skrubis/vectrix-vehicleman/kicad/2025-03-03 01_26_59-ESP32-WROVER-E-PINOUT-DIAGRAM-scaled.jpg (WEBP Image, 1600 × 1153 pixels) – Scal.png

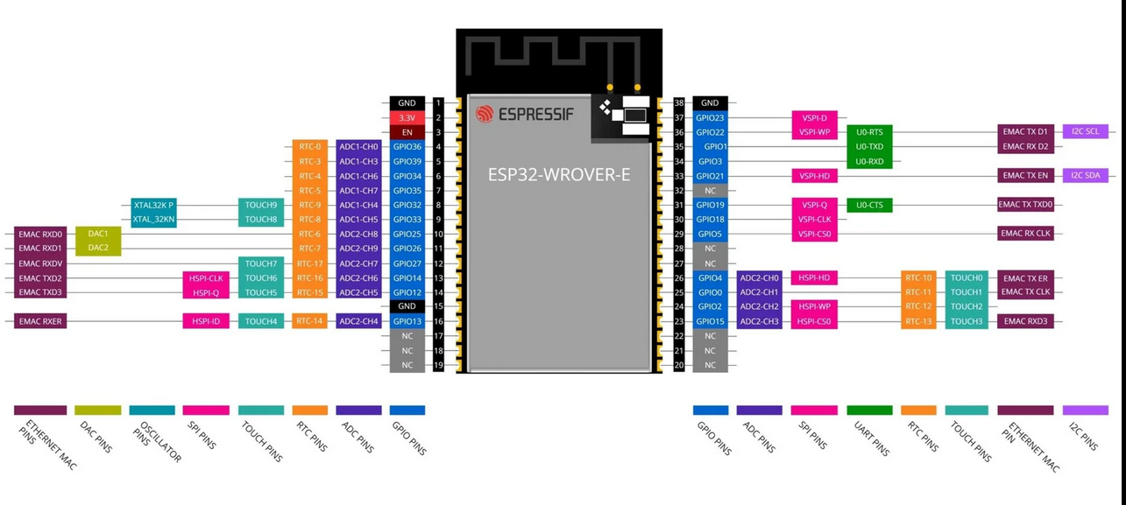
kicad/2025-03-03 01_26_59-ESP32-WROVER-E-PINOUT-DIAGRAM-scaled.jpg (WEBP Image, 1600 × 1153 pixels) – Scal.png
