skrubis/vectrix-vehicleman/other-hw/battery-tap-fuse-adapter/battery-fuse-adapter/production/bom.csv

Designator | Footprint | Quantity | Value | LCSC Part #
F1, F10, F11, F12, F13, F14, F15, F16, F17, F2, F3, F4, F5, F6, F7, F8, F9 | 0603 | 17 | 100mA PF | C369142
J2 | C430372 | 1 | Screw_Terminal_01x17 | C430372
