skrubis/vectrix-vehicleman/kicad/TL494x.step

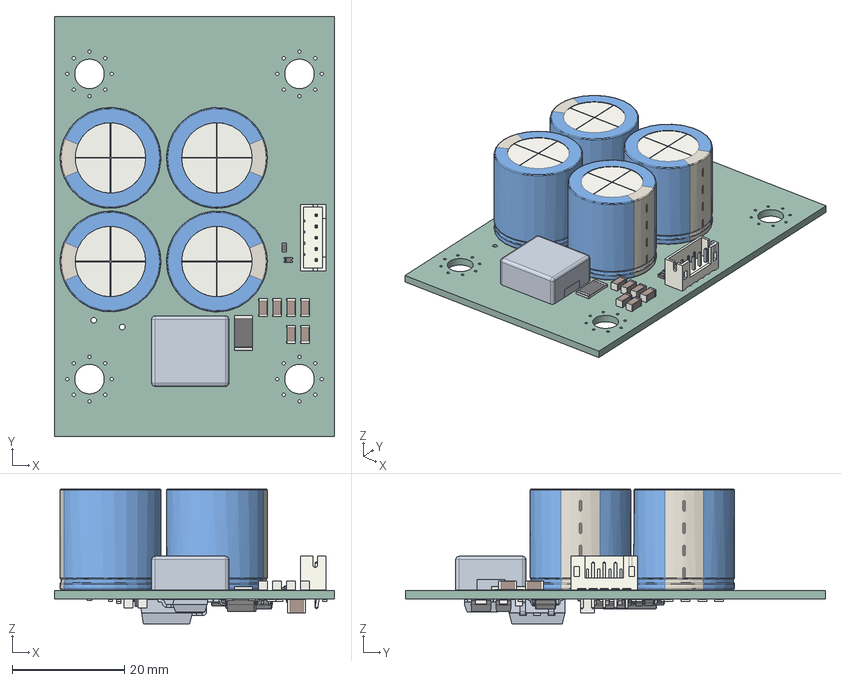
[picture p2: CAD file, 2025-03-02]
kicad/TL494x.step
50.0 x 75.0 x 24.1 mm
CP_Radial_D18.0mm_P7.50mm x 4
JST_PH_B5B-PH-K_1x05_P2.00mm_Vertical
TL494x 1.4.1
C_1206_3216Metric x 8
R_0603_1608Metric x 26
D_0603_1608Metric
R_2512_6332Metric
SOT-23 x 2
SOIC-8_3.9x4.9mm_P1.27mm
D_SOD-323 x 2
SOT-363_SC-70-6
C_0603_1608Metric x 7
C_1210_3225Metric
D_SMA
SOT-223
D_SMB
TL494x 1.52.1
C_0805_2012Metric
SOIC-16_3.9x9.9mm_P1.27mm
TL494x 1.57.1
TL494V2OC_PCB
