skrubis/vectrix-vehicleman/kicad/vectrix-vehicleman-0.pdf

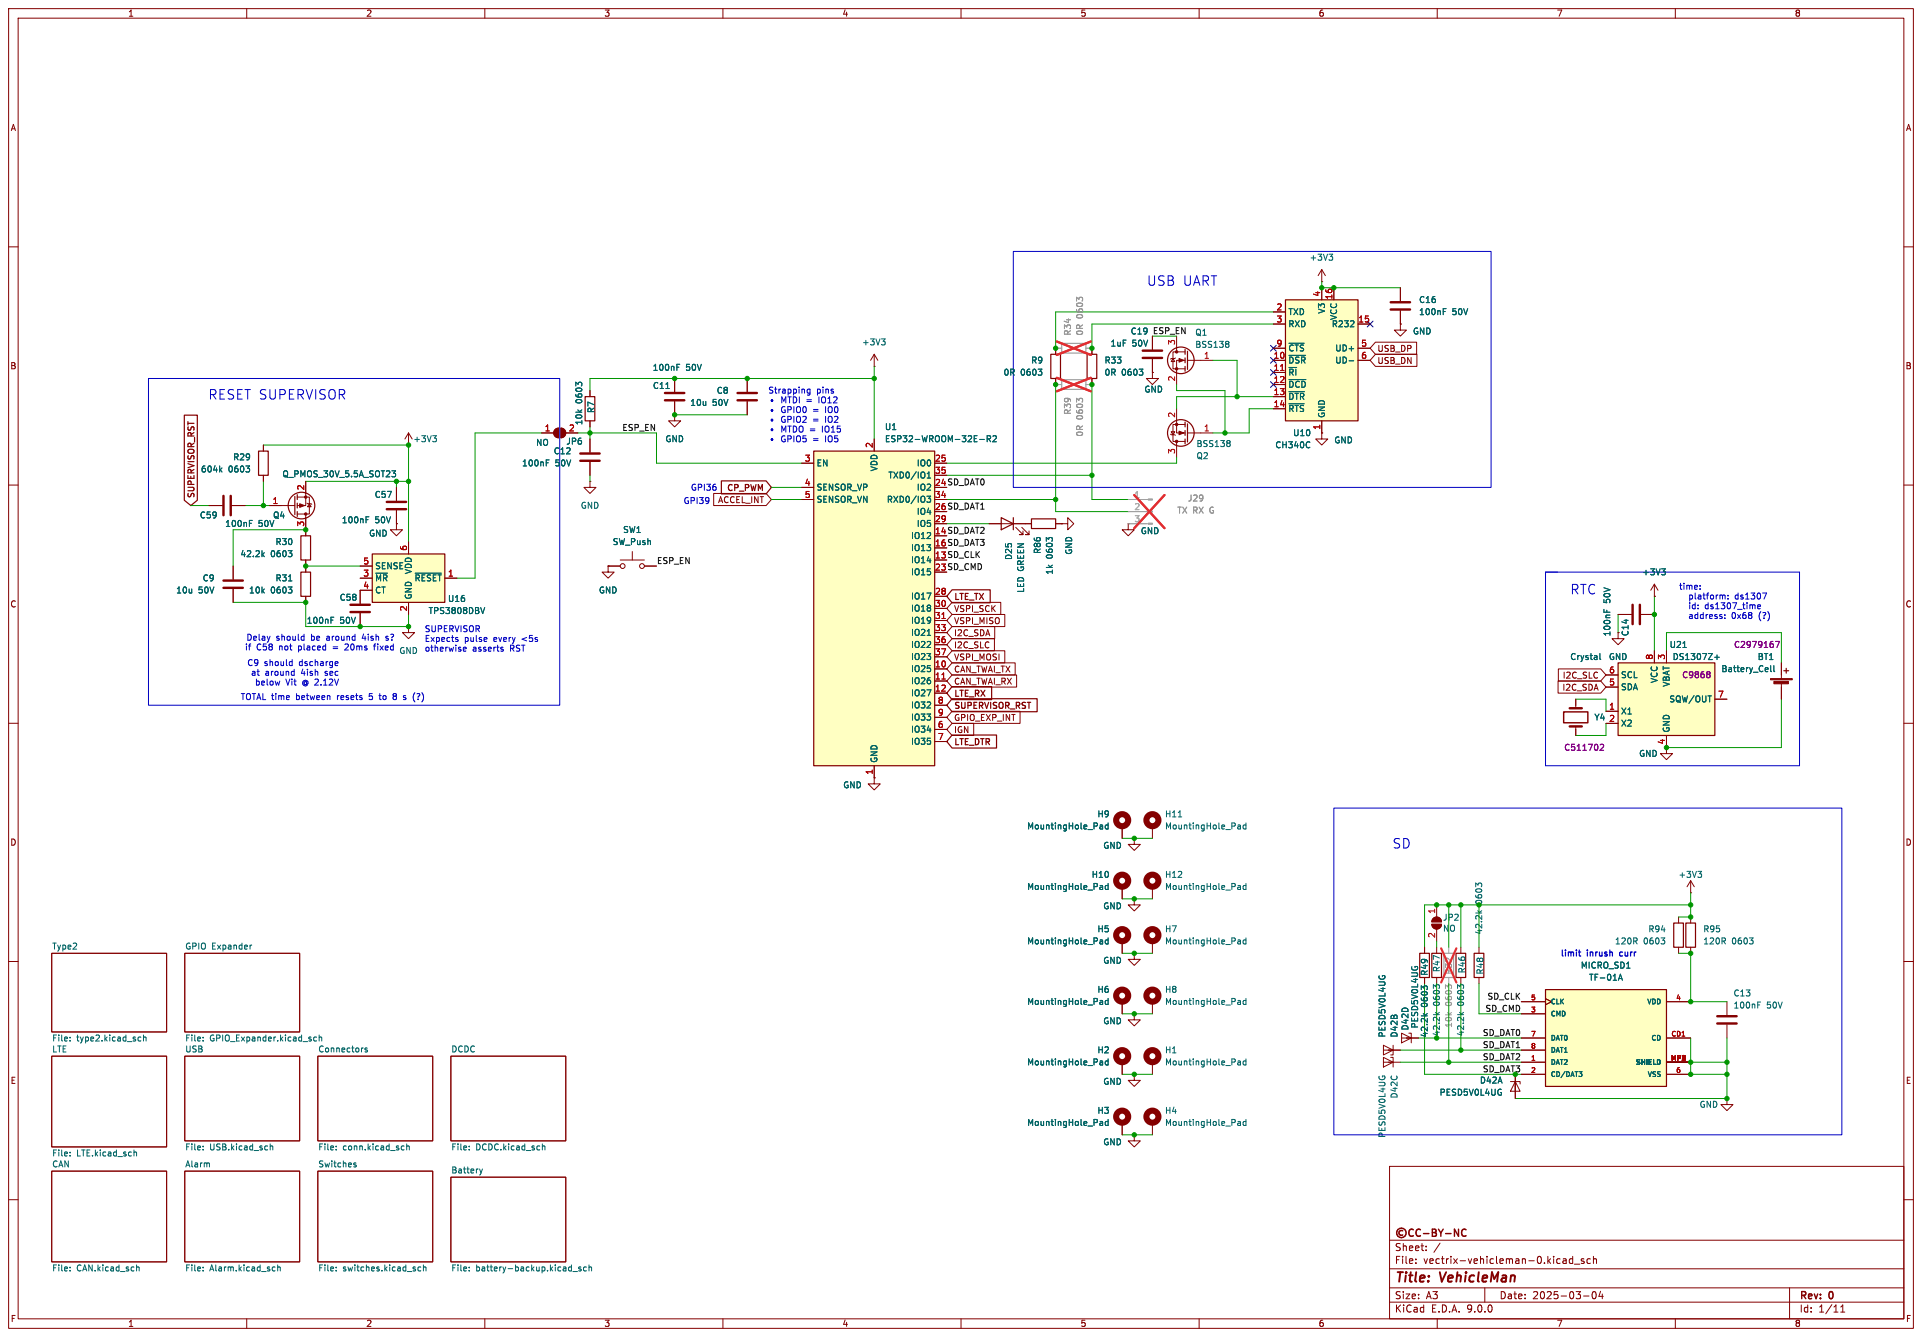
[picture p3: page 1]

1 TXD 2 RXD 3 ~{CTS} 9 ~{DSR} 10 ~{RI} 11 ~{DCD} 12 ~{DTR} 13 ~{RTS} 14 GND GND R34 0R 0603

1 TXD 2 RXD 3 ~{CTS} 9 ~{DSR} 10 ~{RI} 11 ~{DCD} 12 ~{DTR} 13 ~{RTS} 14 U10 CH340C GND

Delay should be around 4ish s?

TOTAL time between resets 5 to 8 s (?)

File: vectrix-vehicleman-0.kicad_sch Sheet: / þÿ©CC-BY-NC

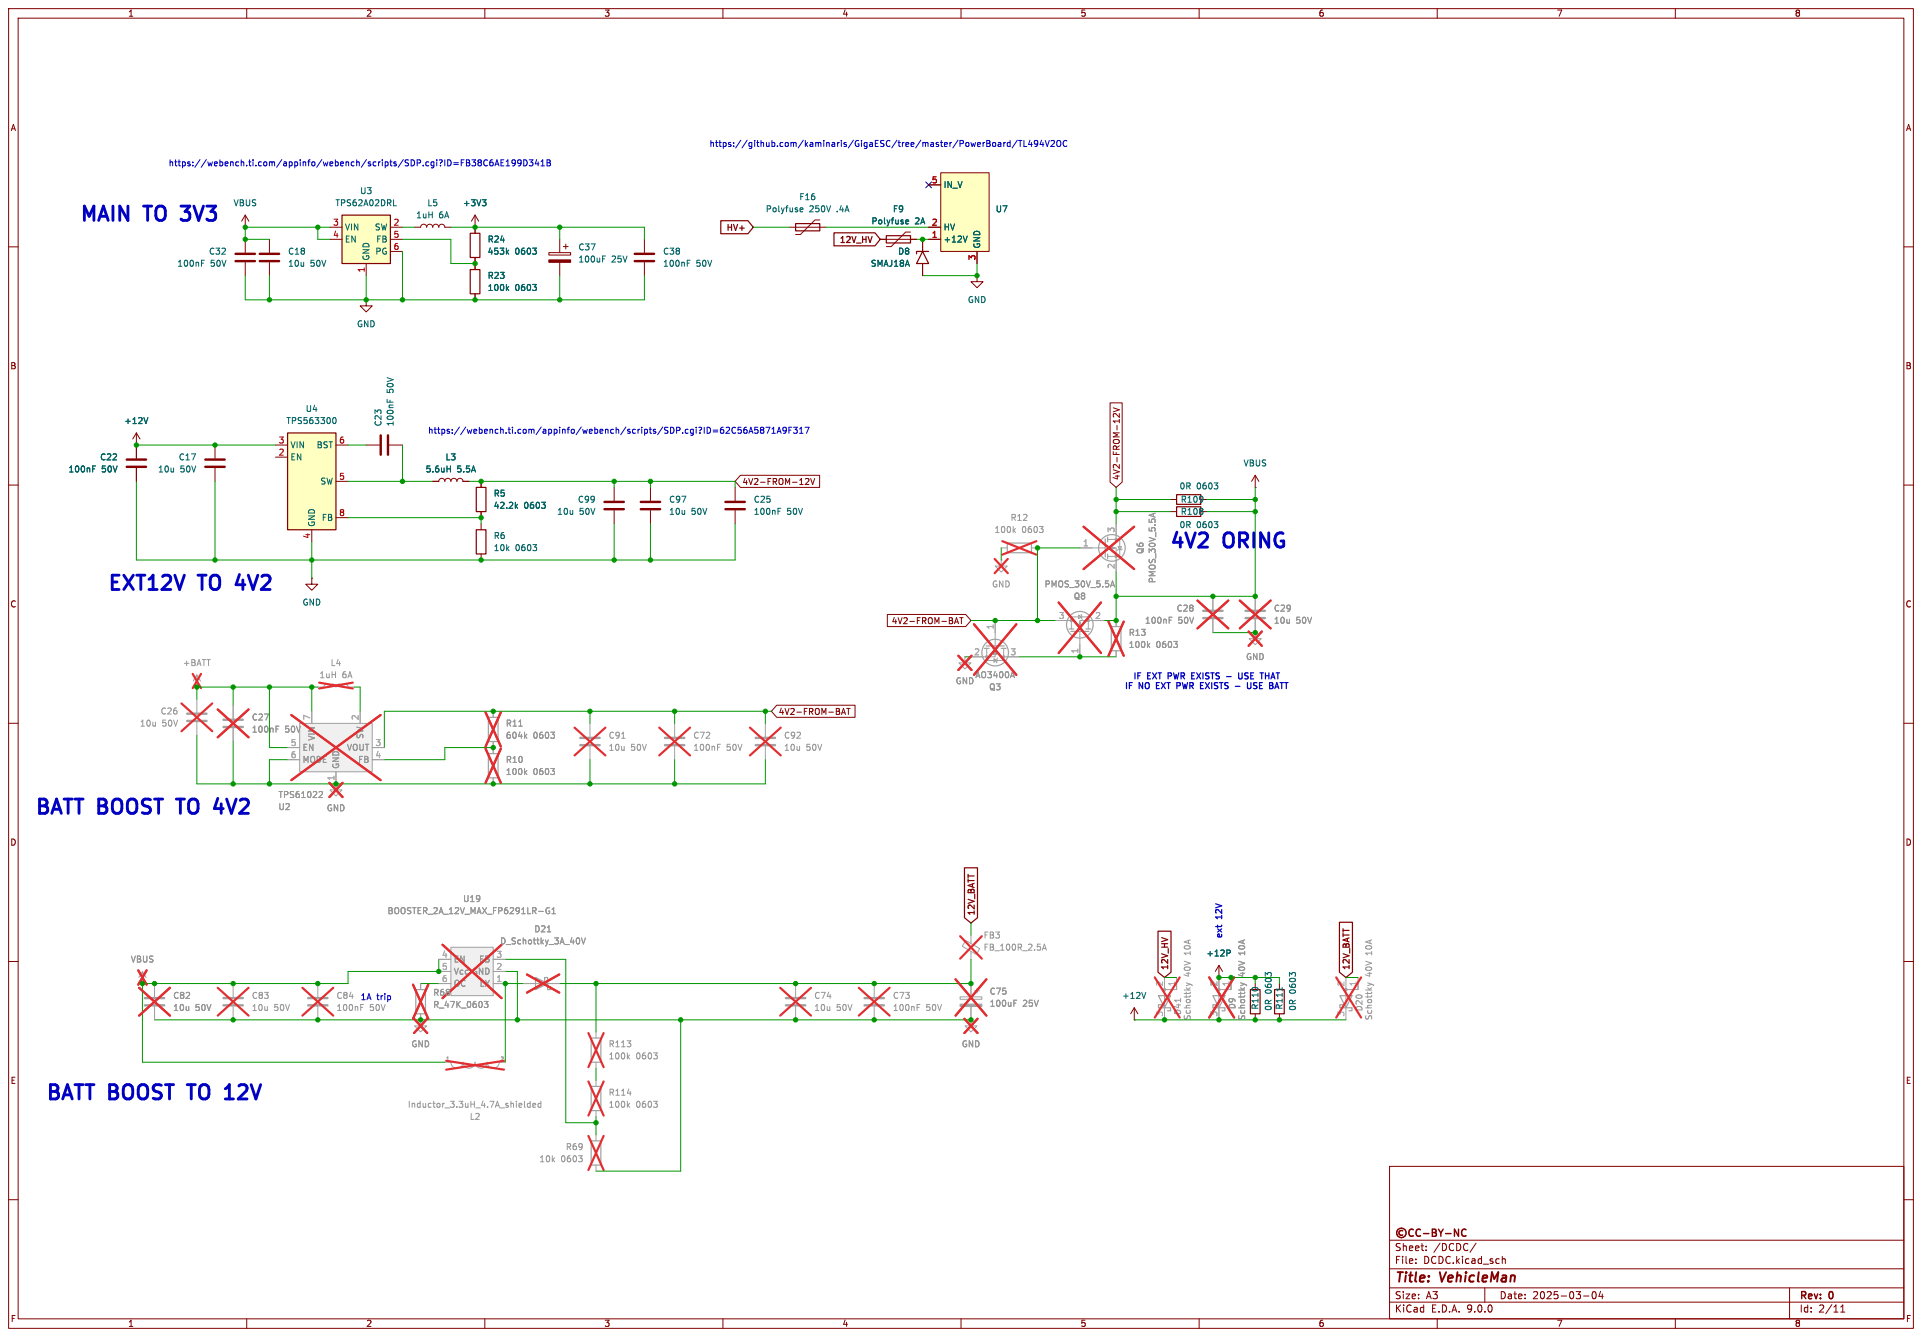
[picture p4: page 2]

https://github.com/kaminaris/GigaESC/tree/master/PowerBoard/TL494V2OC

https://webench.ti.com/appinfo/webench/scripts/SDP.cgi?ID=62C56A5871A9F317

IF NO EXT PWR EXISTS - USE BATT EXT12V TO 4V2

IF EXT PWR EXISTS - USE THAT

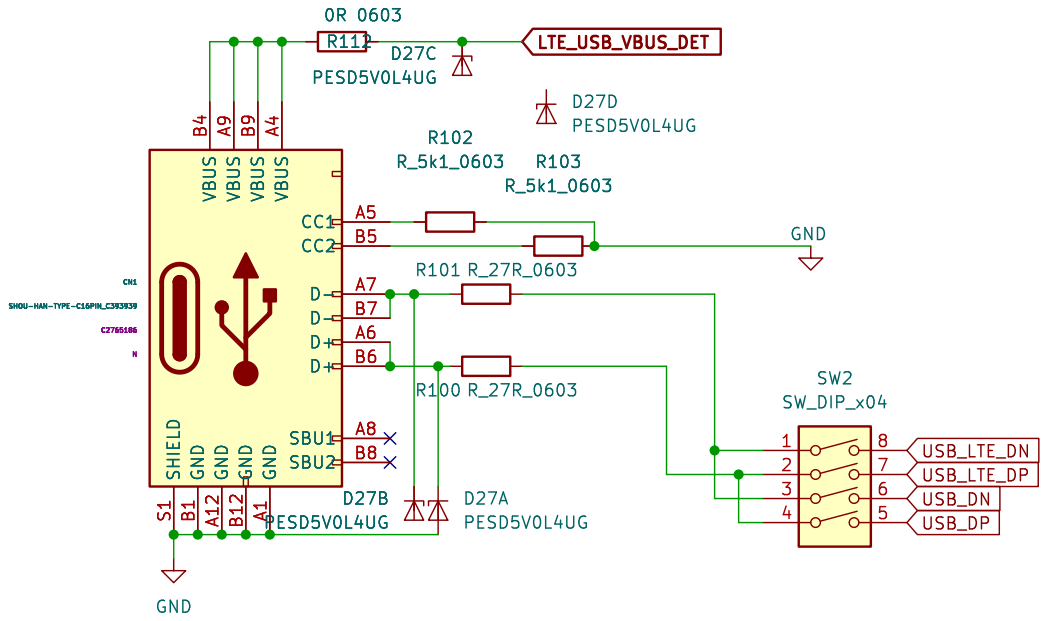
[picture p5: page 3]

File: USB.kicad_sch Sheet: /USB/ þÿ©CC-BY-NC

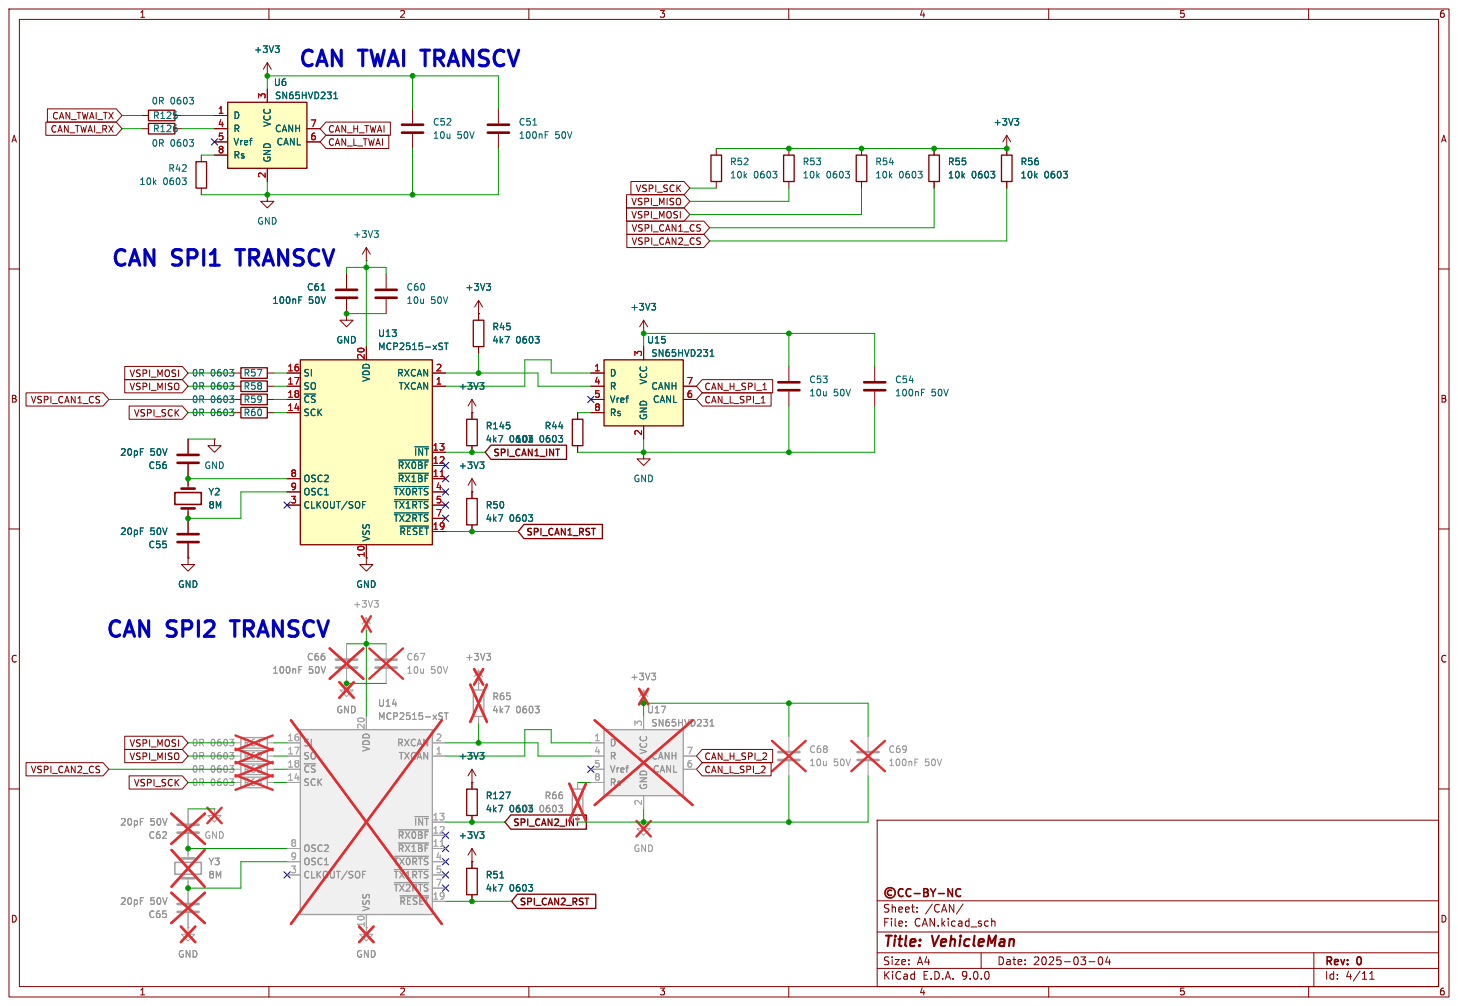
[picture p6: page 4]

File: CAN.kicad_sch Sheet: /CAN/ þÿ©CC-BY-NC

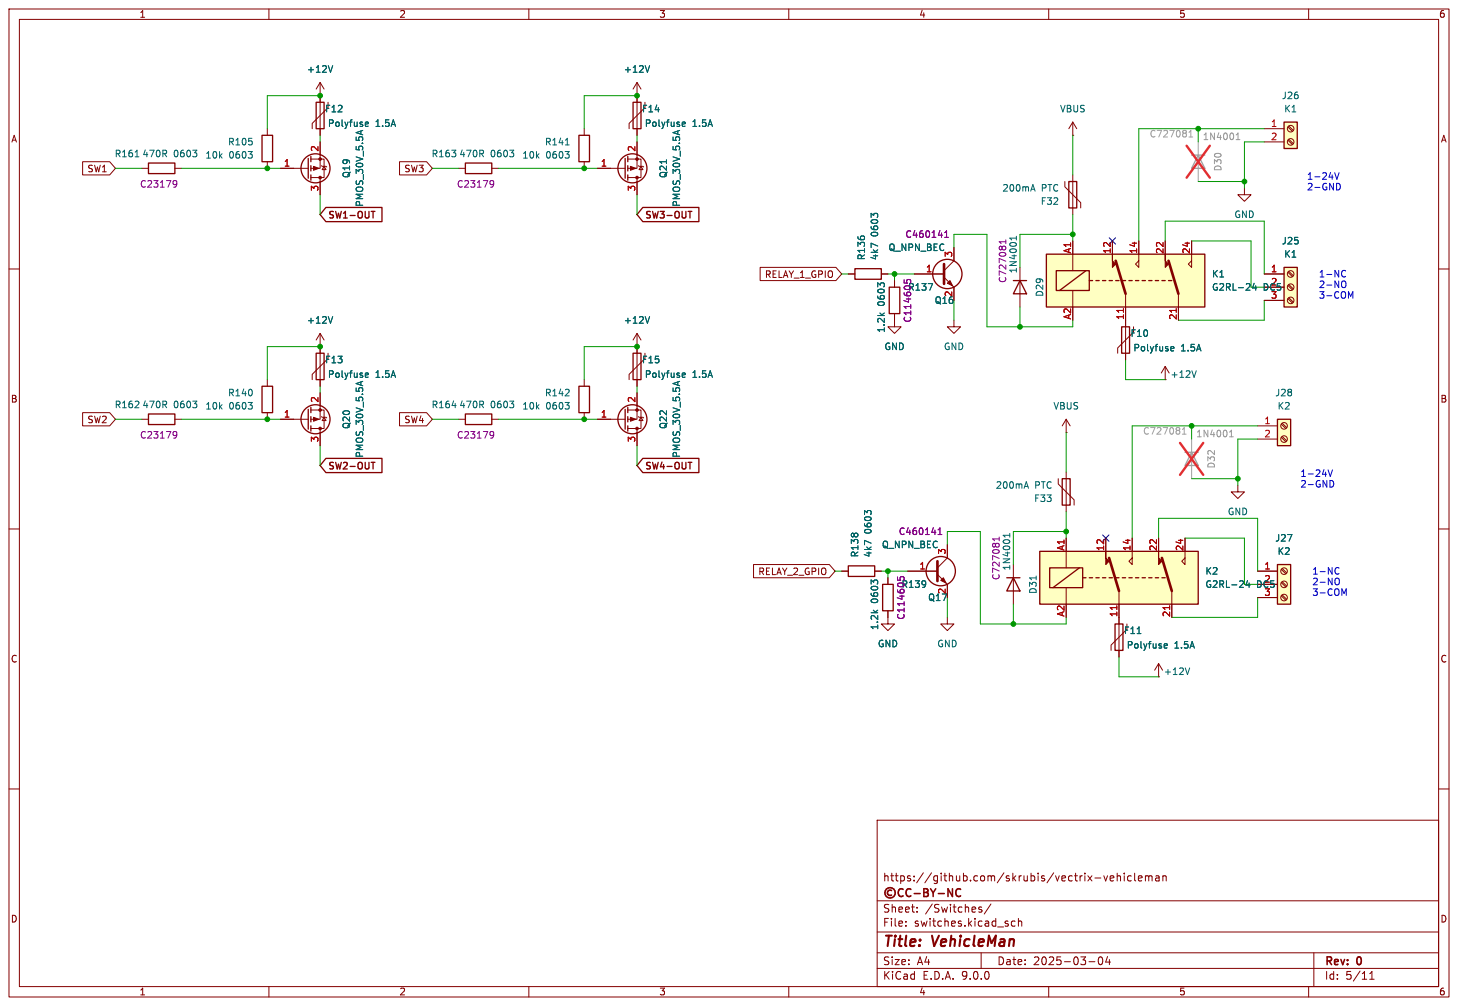
[picture p7: page 5]

https://github.com/skrubis/vectrix-vehicleman D31 1N4001 C727081 1

File: switches.kicad_sch Sheet: /Switches/ þÿ©CC-BY-NC

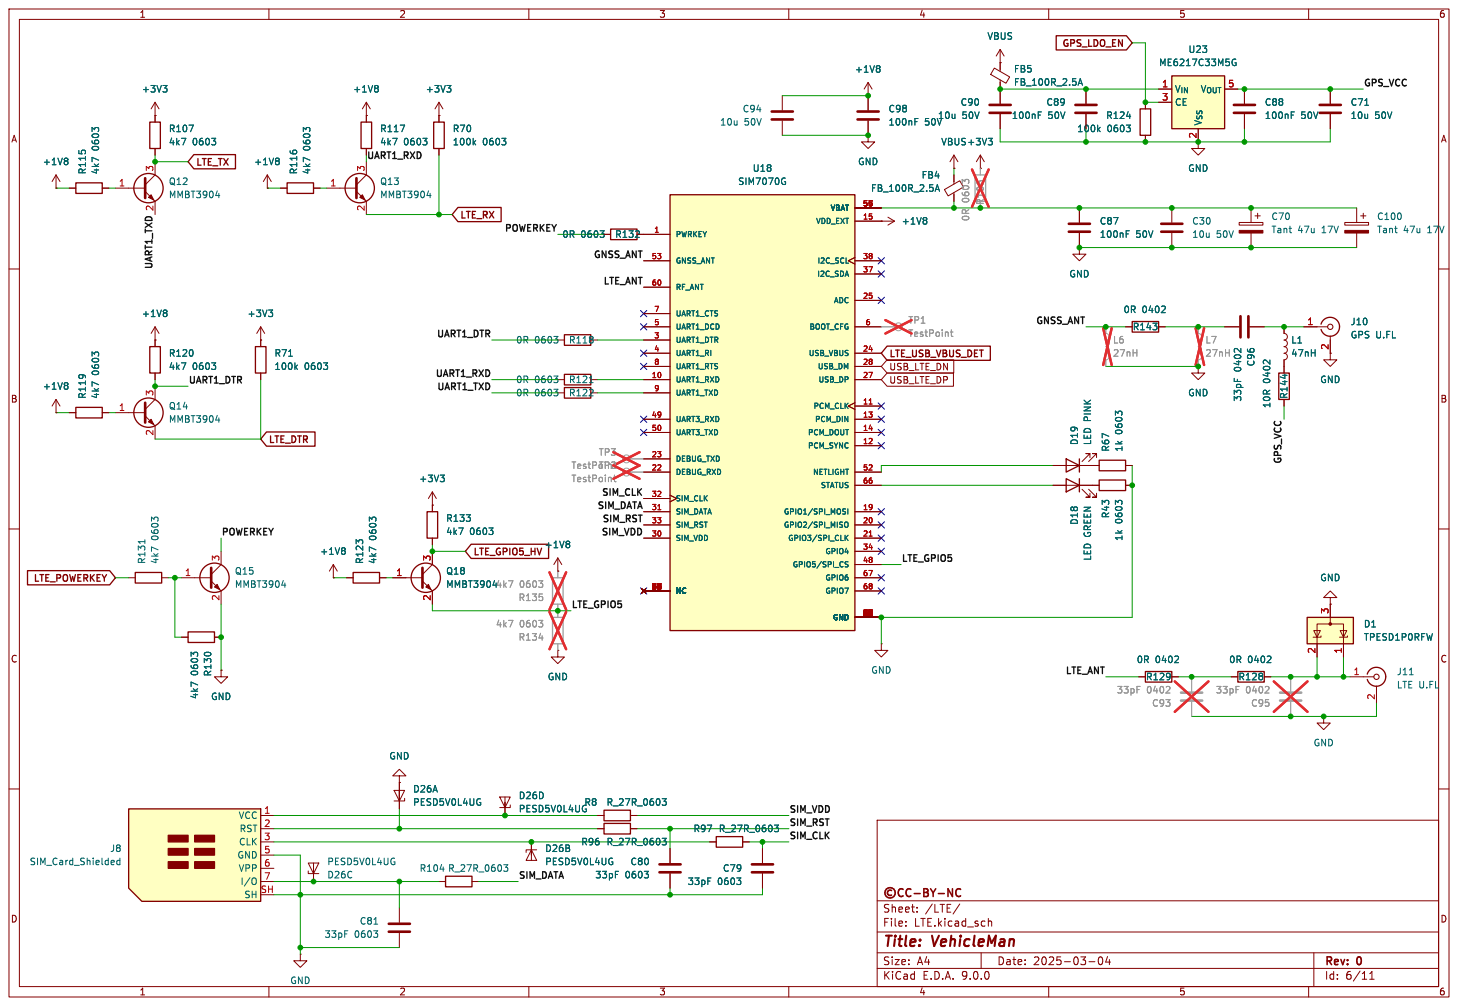
[picture p8: page 6]

+1V8 VCC 1 RST 2 CLK 3 GND 5 VPP 6

File: LTE.kicad_sch Sheet: /LTE/ þÿ©CC-BY-NC

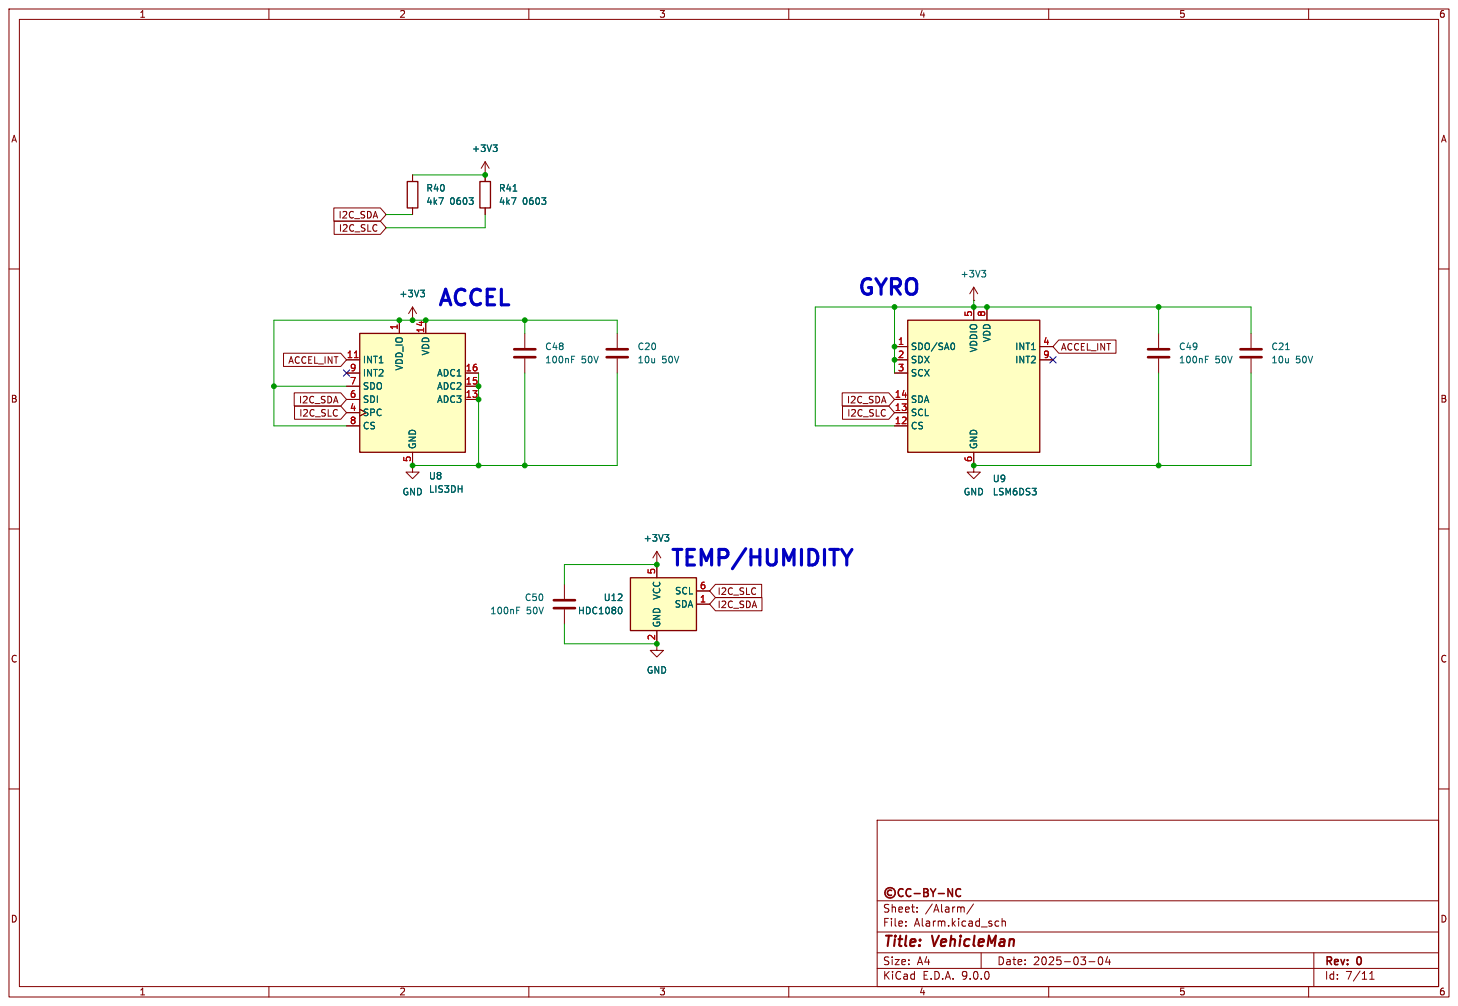
[picture p9: page 7]

File: Alarm.kicad_sch Sheet: /Alarm/ þÿ©CC-BY-NC

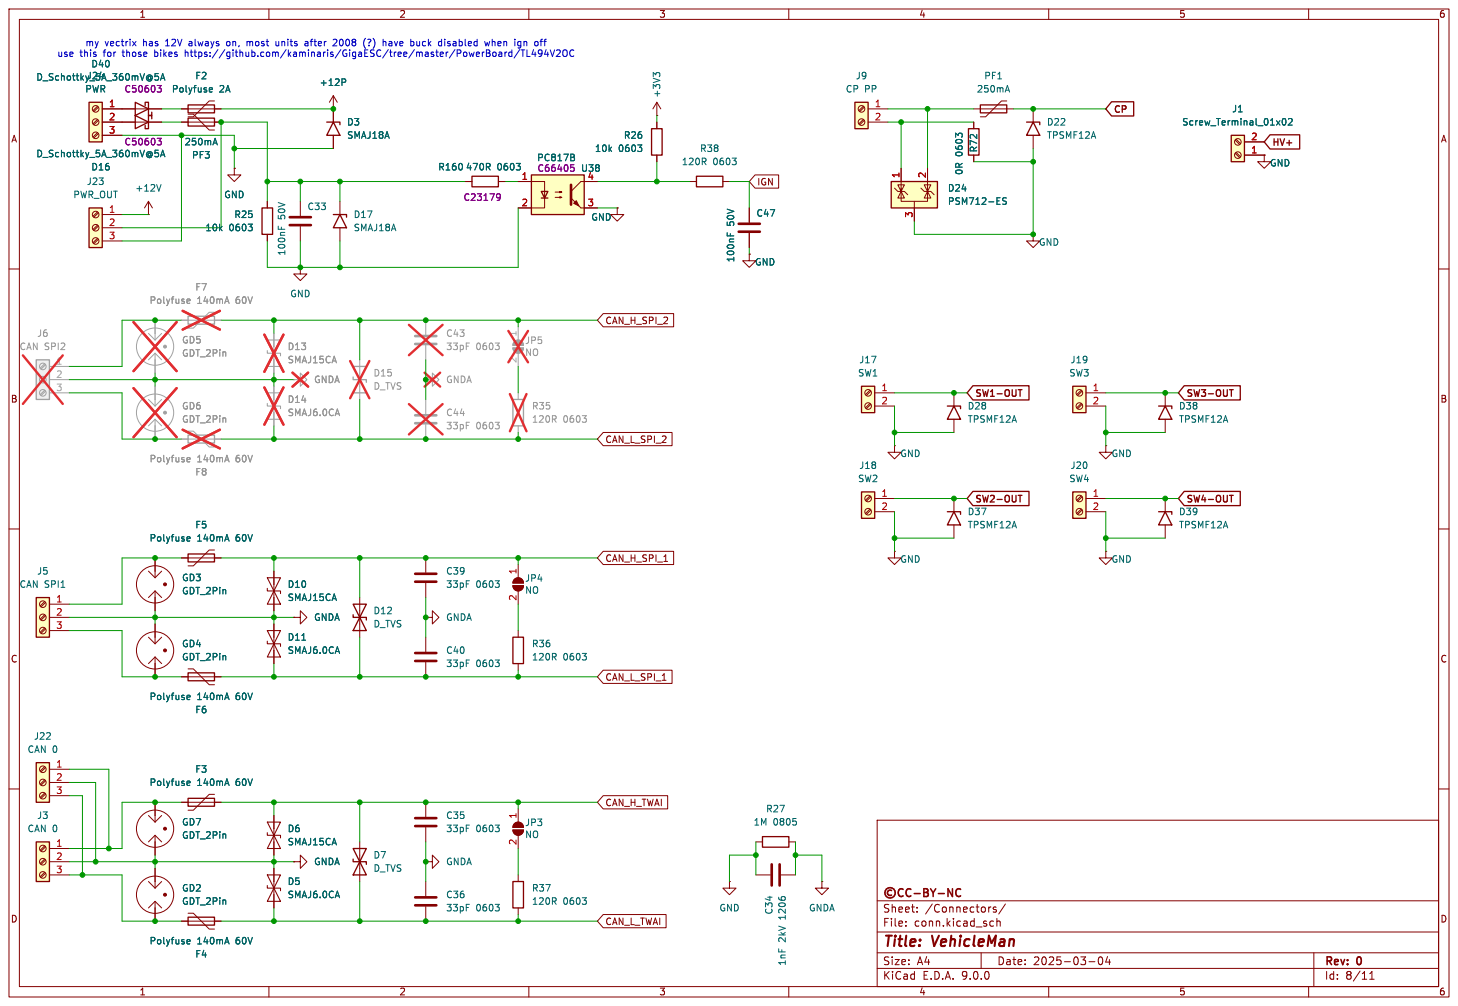
[picture p10: page 8]

File: conn.kicad_sch Sheet: /Connectors/ þÿ©CC-BY-NC

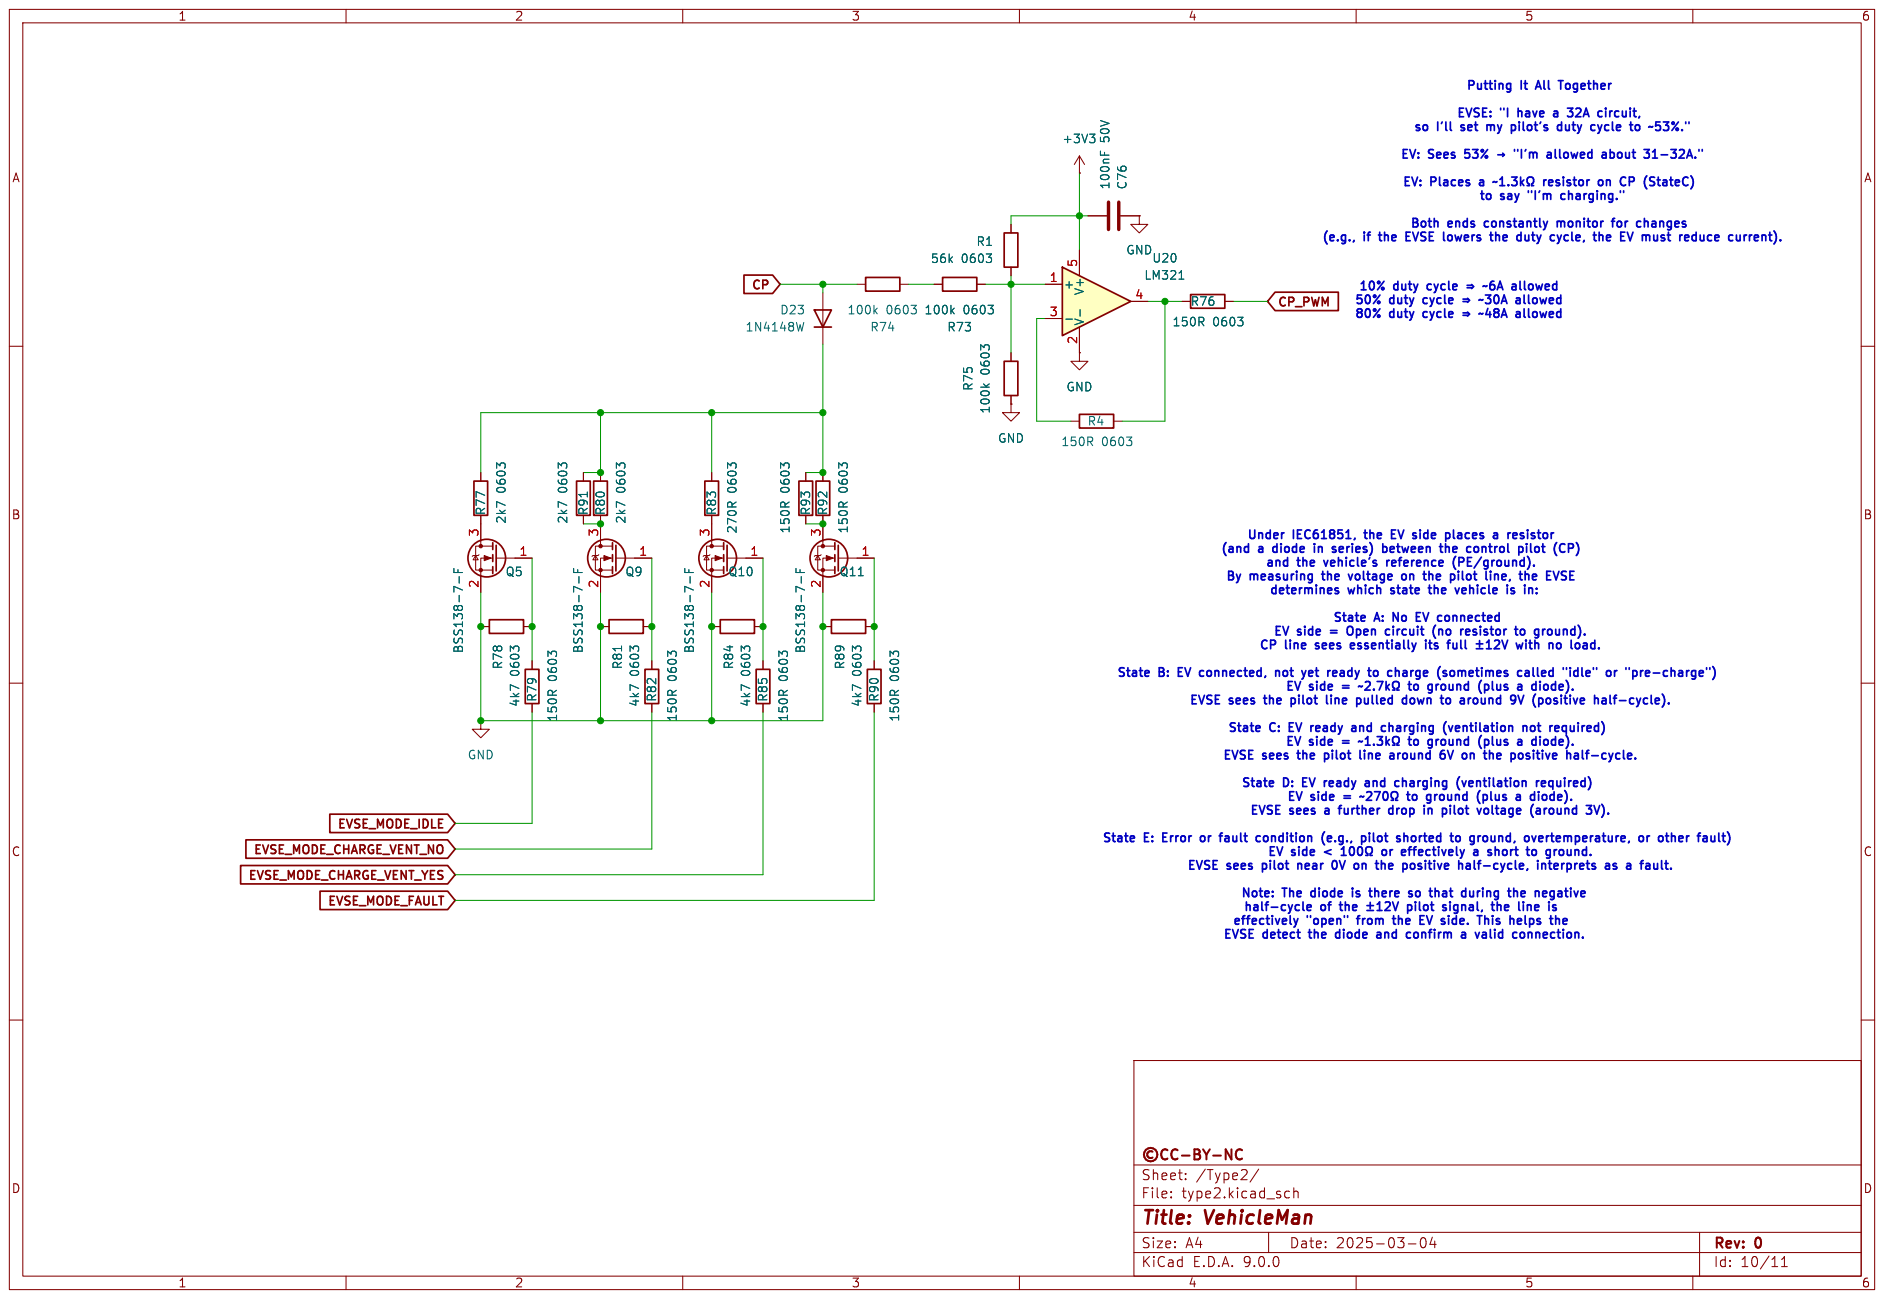
[picture p11: page 9]

80% duty cycle þÿ!Òþÿ~48 /A allowed Putting It All Together EVSE: "I have a þÿ32 /Acircuit, so I'll set my pilot's duty cycle to ~53%." EV: Sees 53% þÿ!’"I'm allowed about þÿ31-32 /A." EV: Places a þÿ~1.3 /k© resistor on CP þÿ(State /C)

to say "I'm charging." Both ends constantly monitor for changes

(e.g., if the EVSE lowers the duty cycle, the EV must reduce current). R75 100k 0603 R1

10% duty cycle þÿ!Òþÿ~6 /A allowed
50% duty cycle þÿ!Òþÿ~30 /A allowed

Under þÿIEC /61851, the EV side places a resistor
(and a diode in series) between the control pilot (CP) and the vehicle's reference (PE/ground).

By measuring the voltage on the pilot line, the EVSE

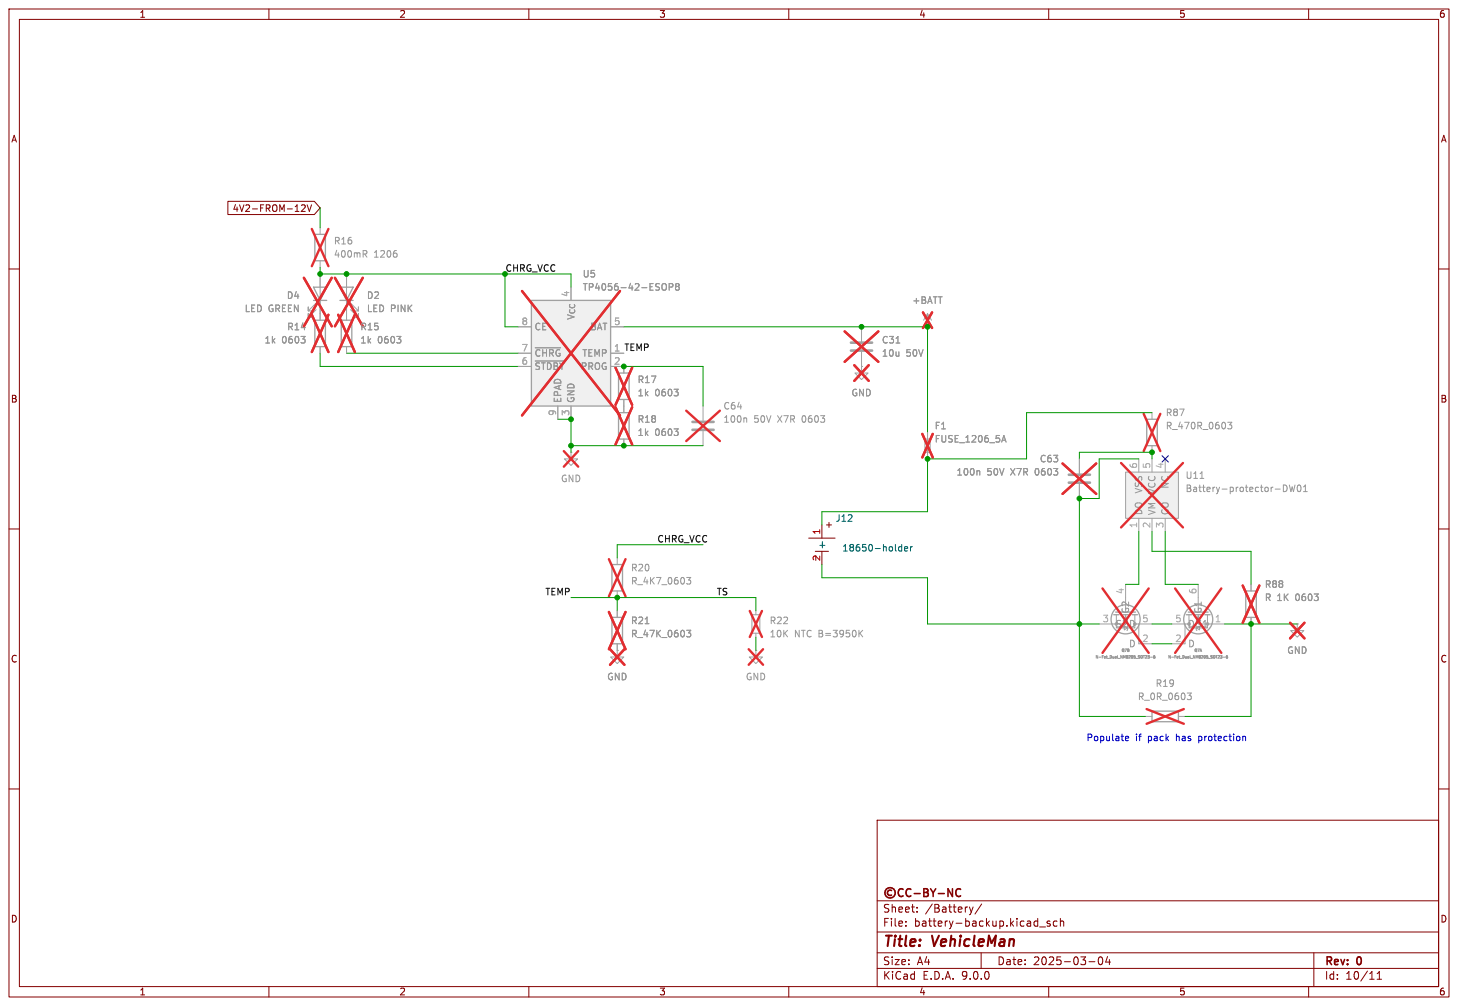
[picture p12: page 10]

File: battery-backup.kicad_sch Sheet: /Battery/
Id: 10/11 Title: VehicleMan

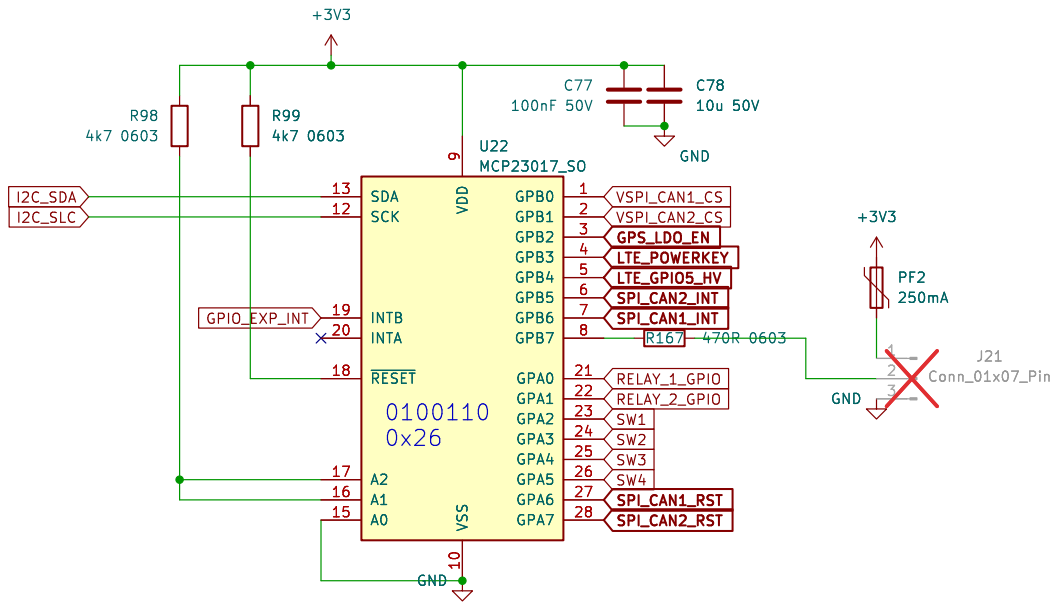
[picture p13: page 11]
