skrubis/vectrix-vehicleman/other-hw/battery-tap-fuse-adapter/battery-fuse-adapter/battery-fuse-adapter.kicad_pcb

## KiCad design other-hw/battery-tap-fuse-adapter/battery-fuse-adapter/battery-fuse-adapter.kicad_pcb (2025-03-06)

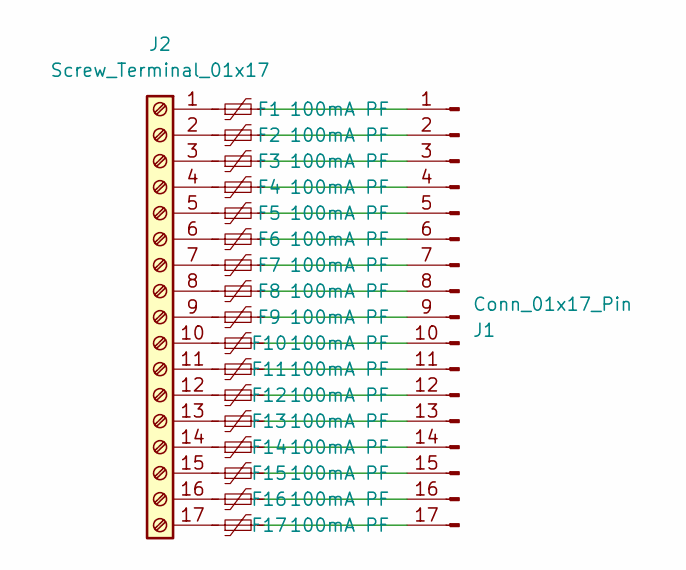
[picture p14: schematic battery-fuse-adapter.kicad_sch]

Parts:
F1, F2, F3, F4, F5, F6, F7, F8, F9, F10, F11, F12, F13, F14, F15, F16, F17: 100mA PF; Fuse_0603_1608Metric; LCSC C369142
J1: Conn_01x17_Pin; PinHeader_1x17_P2.54mm_Vertical
J2: Screw_Terminal_01x17; C430372; LCSC C430372

Connections:
unnamed: F1.2, J1.1
unnamed: F2.2, J1.2
unnamed: F3.2, J1.3
unnamed: F4.2, J1.4
unnamed: F5.2, J1.5
unnamed: F6.2, J1.6
unnamed: F7.2, J1.7
unnamed: F8.2, J1.8
unnamed: F9.2, J1.9
unnamed: F10.2, J1.10
unnamed: F11.2, J1.11
unnamed: F12.2, J1.12
unnamed: F13.2, J1.13
unnamed: F14.2, J1.14
unnamed: F15.2, J1.15
unnamed: F16.2, J1.16
unnamed: F17.2, J1.17
unnamed: F1.1, J2.1
unnamed: F2.1, J2.2
unnamed: F3.1, J2.3
unnamed: F4.1, J2.4
unnamed: F5.1, J2.5
unnamed: F6.1, J2.6
unnamed: F7.1, J2.7
unnamed: F8.1, J2.8
unnamed: F9.1, J2.9
unnamed: F10.1, J2.10
unnamed: F11.1, J2.11
unnamed: F12.1, J2.12
unnamed: F13.1, J2.13
unnamed: F14.1, J2.14
unnamed: F15.1, J2.15
unnamed: F16.1, J2.16
unnamed: F17.1, J2.17

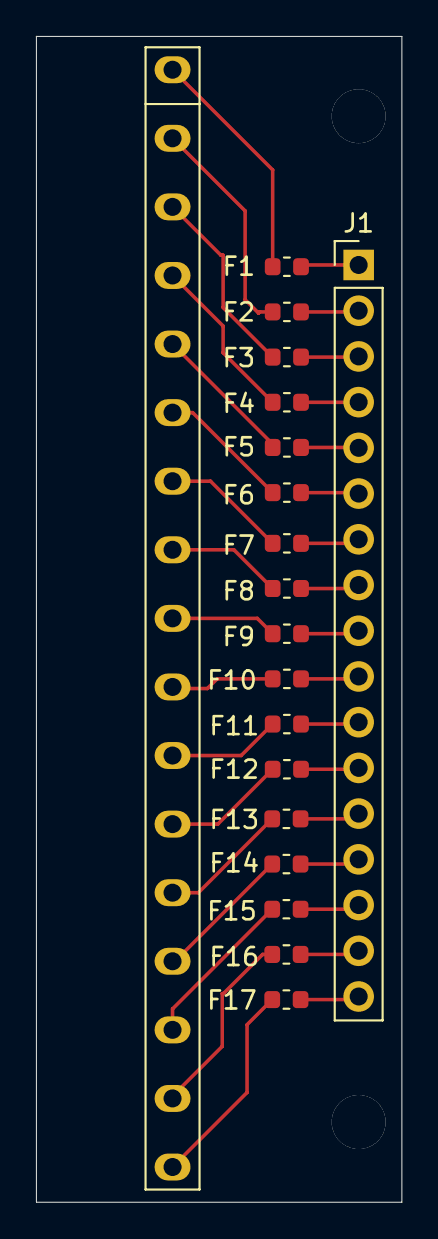
[picture p15: board battery-fuse-adapter.kicad_pcb from above]

Board: 2 copper layers, 20.3 x 64.8 mm, 19 parts (0 on the bottom side), 34 nets.
