skrubis/vectrix-vehicleman/kicad/vectrix-vehicleman-0.kicad_pcb

## KiCad design kicad/vectrix-vehicleman-0.kicad_pcb (2025-03-05)

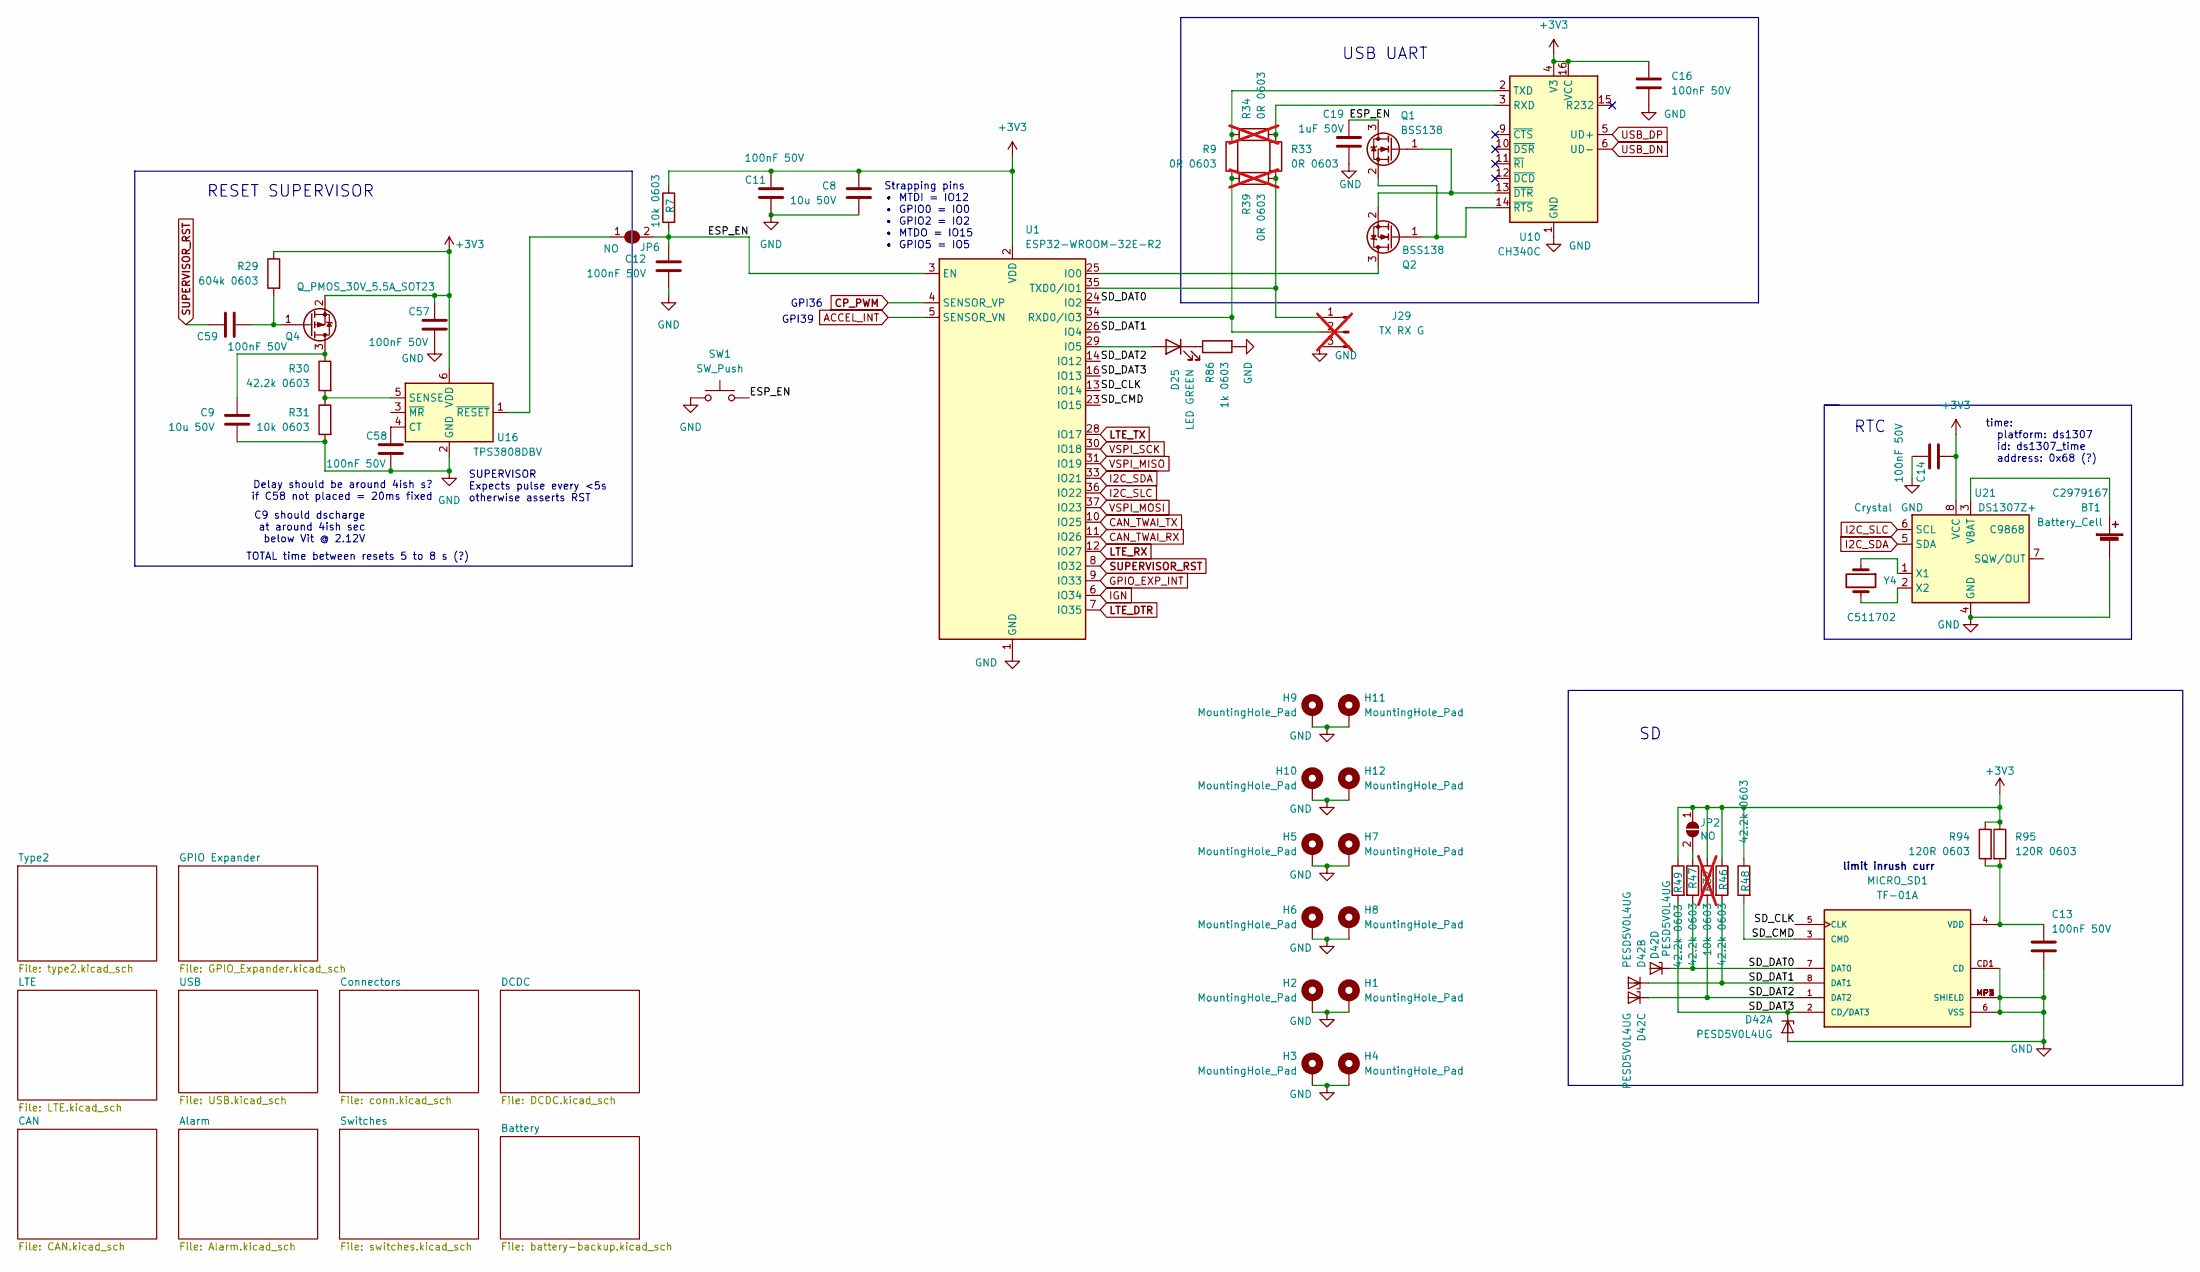
[picture p16: schematic vectrix-vehicleman-0.kicad_sch, VehicleMan]

Parts:
BT1: Battery_Cell; BatteryHolder_MYOUNG_BS-07-A1BJ001_CR2032; LCSC C2979167
C8, C9: 10u 50V; C_1206_3216Metric; LCSC C13585
C11, C12, C13, C14, C16, C57, C58, C59: 100nF 50V; C_0603_1608Metric; LCSC C14663
C19: 1uF 50V; C_0603_1608Metric; LCSC C6119852
D25: LED GREEN; LED_0805_2012Metric; LCSC C5875740
D42: PESD5V0L4UG; SOT-353_SC-70-5; LCSC C5116450
H1, H2, H3, H4, H5, H6, H7, H8, H9, H10, H11, H12: MountingHole_Pad; MountingHole_3.2mm_M3_DIN965_Pad_TopBottom
J29: TX RX G; PinHeader_1x03_P1.27mm_Vertical; not fitted
JP2, JP6: NO; SolderJumper-2_P1.3mm_Open_TrianglePad1.0x1.5mm
MICRO_SD1: TF-01A; LCSC C91145
Q1, Q2: BSS138; SOT-23; LCSC C112239
Q4: Q_PMOS_30V_5.5A_SOT23; SOT-23; LCSC C105162
R7, R31: 10k 0603; R_0603_1608Metric; LCSC C2930027
R9, R33: 0R 0603; R_0603_1608Metric; LCSC C21189
R29: 604k 0603; R_0603_1608Metric; LCSC C2933246
R30, R46, R47, R48, R49: 42.2k 0603; R_0603_1608Metric; LCSC C5126245
R32: 10k 0603; R_0603_1608Metric; LCSC C2930027; not fitted
R34, R39: 0R 0603; R_0603_1608Metric; LCSC C21189; not fitted
R86: 1k 0603; R_0603_1608Metric; LCSC C2907113
R94, R95: 120R 0603; R_0603_1608Metric; LCSC C22787
SW1: SW_Push; SW_PUSH_6mm; LCSC C455095
U1: ESP32-WROOM-32E-R2; ESP32-WROOM-32D; LCSC C82899
U10: CH340C; SOIC-16_3.9x9.9mm_P1.27mm; LCSC C84681
U16: TPS3808DBV; SOT-23-6; LCSC C19653
U21: DS1307Z+; SOIC-8_3.9x4.9mm_P1.27mm; LCSC C9868
Y4: Crystal; Crystal_DS26_D2.0mm_L6.0mm_Horizontal; LCSC C511702

Connections:
+3V3: C8.1, C11.1, C14.2, C16.1, C57.1, JP2.1 (A), Q4.2 (S), R7.1, R29.1, R32.1, R46.1, R48.1, R49.1, R94.1, R95.1, U1.2 (VDD), U10.4 (V3), U10.16 (VCC), U16.6 (VDD), U21.8 (VCC); also elsewhere on the board
/ESP_EN: C12.1, C19.1, JP6.2 (B), Q1.3 (D), R7.2, SW1.2, U1.3 (EN)
/SD_CLK: MICRO_SD1.5 (CLK), U1.13 (IO14)
/SD_CMD: MICRO_SD1.3 (CMD), R48.2, U1.23 (IO15)
/SD_DAT0: D42.5 (K4), MICRO_SD1.7 (DAT0), R47.2, U1.24 (IO2)
/SD_DAT1: D42.3 (K2), MICRO_SD1.8 (DAT1), R46.2, U1.26 (IO4)
/SD_DAT2: D42.4 (K3), MICRO_SD1.1 (DAT2), R32.2, U1.14 (IO12)
/SD_DAT3: D42.1 (K1), MICRO_SD1.2 (CD/DAT3), R49.2, U1.16 (IO13)
ACCEL_INT: U1.5 (SENSOR_VN); also elsewhere on the board
CAN_TWAI_RX: U1.11 (IO26); also elsewhere on the board
CAN_TWAI_TX: U1.10 (IO25); also elsewhere on the board
CP_PWM: U1.4 (SENSOR_VP); also elsewhere on the board
GND: BT1.2 (-), C8.2, C9.2, C11.2, C12.2, C13.2, C14.1, C16.2, C19.2, C57.2, C58.2, D42.2 (A), H1.1, H2.1, H3.1, H4.1, H5.1, H6.1, H7.1, H8.1, H9.1, H10.1, H11.1, H12.1, J29.3, MICRO_SD1.6 (VSS), MICRO_SD1.CD1 (CD), MICRO_SD1.MP1 (SHIELD), MICRO_SD1.MP2 (SHIELD), MICRO_SD1.MP3 (SHIELD), MICRO_SD1.MP4 (SHIELD), R31.2, R86.2, SW1.1, U1.1 (GND), U1.15 (GND), U1.38 (GND), U1.39 (GND), U10.1 (GND), U16.2 (GND), U21.4 (GND); also elsewhere on the board
GPIO_EXP_INT: U1.9 (IO33); also elsewhere on the board
I2C_SDA: U1.33 (IO21), U21.5 (SDA); also elsewhere on the board
I2C_SLC: U1.36 (IO22), U21.6 (SCL); also elsewhere on the board
IGN: U1.6 (IO34); also elsewhere on the board
LTE_DTR: U1.7 (IO35); also elsewhere on the board
LTE_RX: U1.12 (IO27); also elsewhere on the board
LTE_TX: U1.28 (IO17); also elsewhere on the board
unnamed: BT1.1 (+), U21.3 (VBAT)
unnamed: D25.2 (A), U1.29 (IO5)
unnamed: D25.1 (K), R86.1
unnamed: J29.1, R33.2, R39.2, U1.35 (TXD0/IO1)
unnamed: J29.2, R9.2, R39.1, U1.34 (RXD0/IO3)
unnamed: JP2.2 (B), R47.1
unnamed: JP6.1 (A), U16.1 (~RESET)
unnamed: C13.1, MICRO_SD1.4 (VDD), R94.2, R95.2
unnamed: Q1.1 (G), Q2.2 (S), U10.13 (~DTR)
unnamed: Q1.2 (S), Q2.1 (G), U10.14 (~RTS)
unnamed: Q2.3 (D), U1.25 (IO0)
unnamed: C9.1, Q4.3 (D), R30.1
unnamed: C59.2, Q4.1 (G), R29.2
unnamed: R33.1, R34.2, U10.3 (RXD)
unnamed: R9.1, R34.1, U10.2 (TXD)
unnamed: C58.1, U16.4 (CT)
unnamed: R30.2, R31.1, U16.5 (SENSE)
unnamed: U21.1 (X1), Y4.1
unnamed: U21.2 (X2), Y4.2
SUPERVISOR_RST: C59.1, U1.8 (IO32)
USB_DN: U10.6 (UD-); also elsewhere on the board
USB_DP: U10.5 (UD+); also elsewhere on the board
VSPI_MISO: U1.31 (IO19); also elsewhere on the board
VSPI_MOSI: U1.37 (IO23); also elsewhere on the board
VSPI_SCK: U1.30 (IO18); also elsewhere on the board

Notes on the sheet:
C9 should dscharge at around 4ish sec below Vit @ 2.12V
SUPERVISOR Expects pulse every <5s otherwise asserts RST
limit inrush curr
TOTAL time between resets 5 to 8 s (?)
RTC
GPI39
GPI36
USB UART
RESET SUPERVISOR
Strapping pins • MTDI = IO12 • GPIO0 = IO0 • GPIO2 = IO2 • MTDO = IO15 • GPIO5 = IO5
time: platform: ds1307 id: ds1307_time address: 0x68 (?)
Delay should be around 4ish s? if C58 not placed = 20ms fixed

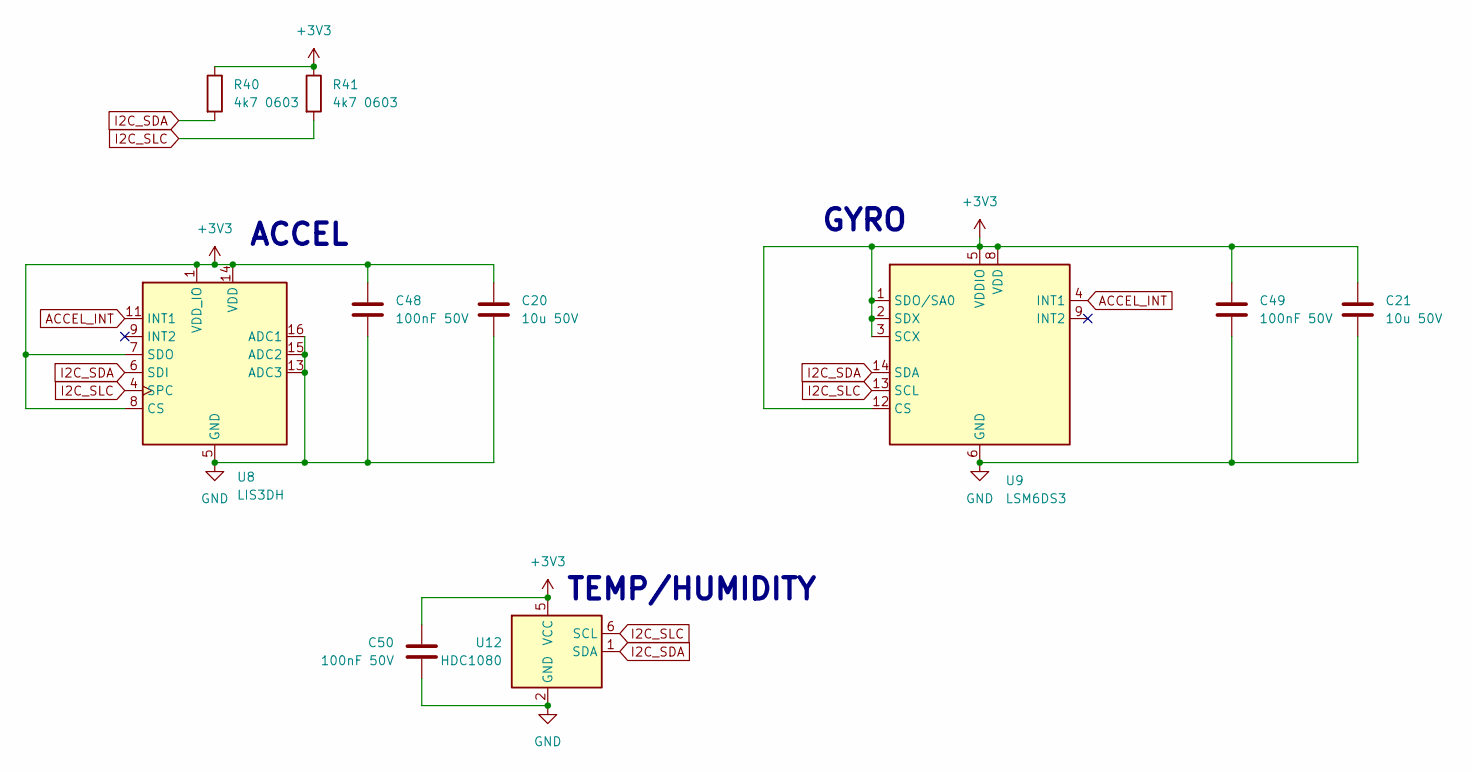
[picture p17: schematic Alarm.kicad_sch, VehicleMan]

Parts:
C20, C21: 10u 50V; C_1206_3216Metric; LCSC C13585
C48, C49, C50: 100nF 50V; C_0603_1608Metric; LCSC C14663
R40, R41: 4k7 0603; R_0603_1608Metric; LCSC C99782
U8: LIS3DH; LGA-16_3x3mm_P0.5mm_LayoutBorder3x5y; LCSC C15134
U9: LSM6DS3; LGA-14_3x2.5mm_P0.5mm_LayoutBorder3x4y; LCSC C967633
U12: HDC1080; Texas_PWSON-N6; LCSC C82227

Connections:
+3V3: C20.1, C21.1, C48.1, C49.1, C50.1, R40.1, R41.1, U8.1 (VDD_IO), U8.7 (SDO), U8.8 (CS), U8.14 (VDD), U9.1 (SDO/SA0), U9.2 (SDX), U9.3 (SCX), U9.5 (VDDIO), U9.8 (VDD), U9.12 (CS), U12.5 (VCC); also elsewhere on the board
ACCEL_INT: U8.11 (INT1), U9.4 (INT1); also elsewhere on the board
GND: C20.2, C21.2, C48.2, C49.2, C50.2, U8.5 (GND), U8.10 (GND), U8.12 (GND), U8.13 (ADC3), U8.15 (ADC2), U8.16 (ADC1), U9.6 (GND), U9.7 (GND), U12.2 (GND); also elsewhere on the board
I2C_SDA: R40.2, U8.6 (SDI), U9.14 (SDA), U12.1 (SDA); also elsewhere on the board
I2C_SLC: R41.2, U8.4 (SPC), U9.13 (SCL), U12.6 (SCL); also elsewhere on the board

Notes on the sheet:
ACCEL
GYRO
TEMP/HUMIDITY

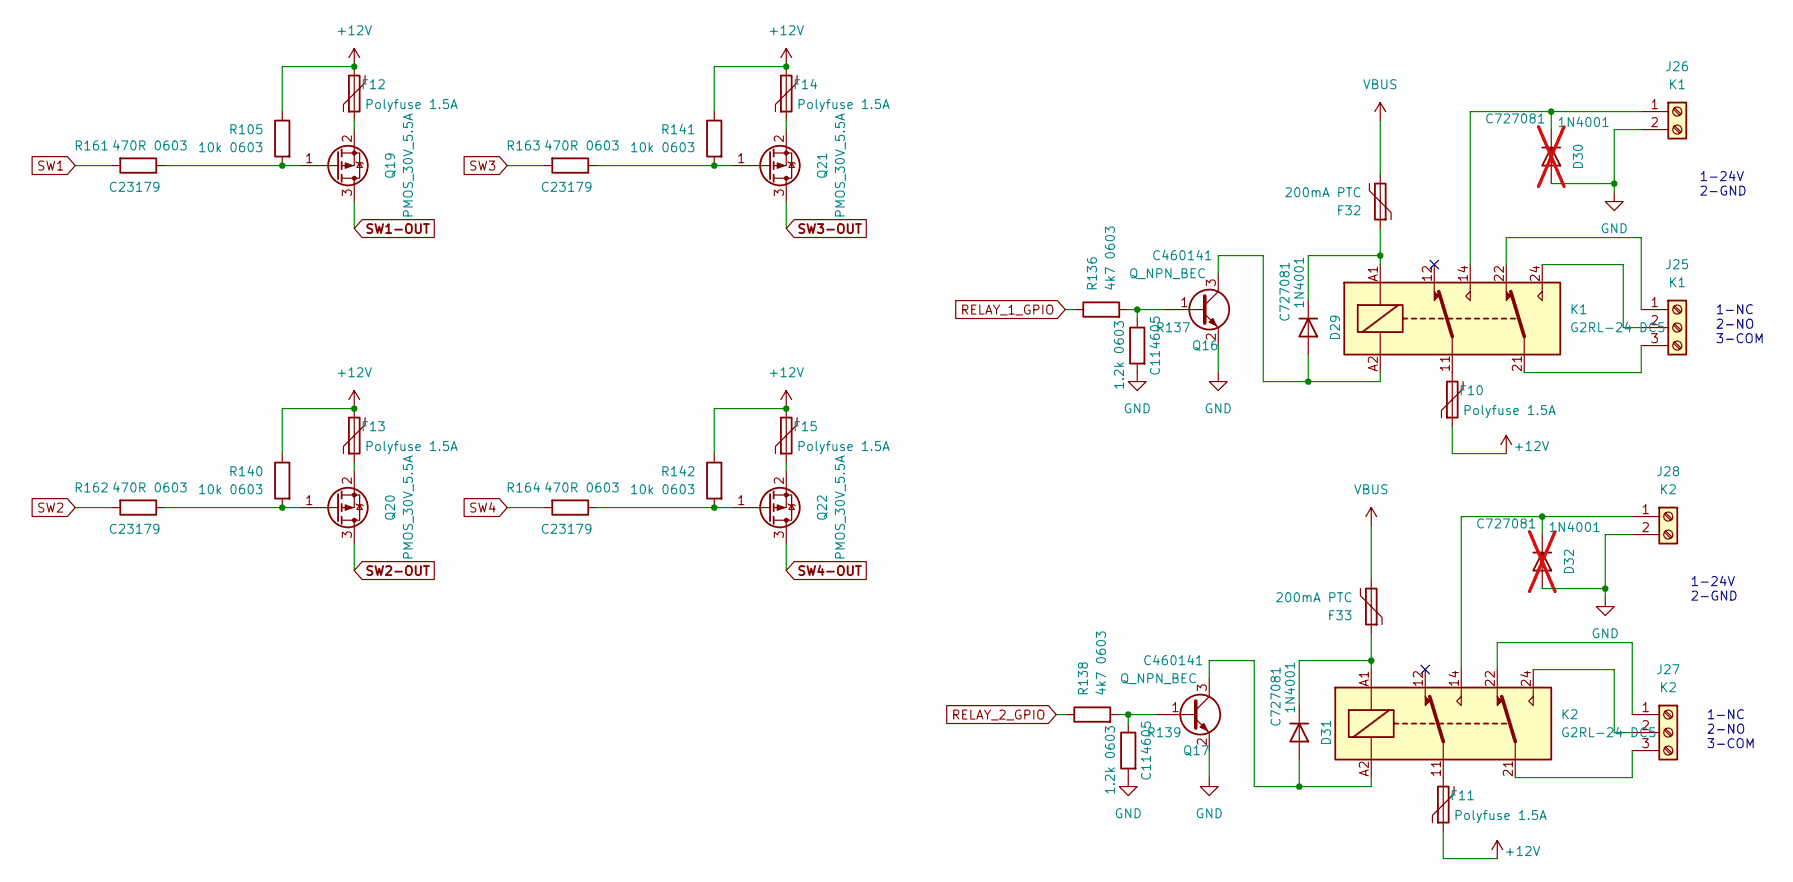
[picture p18: schematic switches.kicad_sch, VehicleMan]

Parts:
D29, D31: 1N4001; D_SMA; LCSC C727081
D30, D32: 1N4001; D_SMA; LCSC C727081; not fitted
F10, F11, F12, F13, F14, F15: Polyfuse 1.5A; Fuse_1812_4532Metric; LCSC C883154
F32, F33: 200mA PTC; Fuse_0805_2012Metric; LCSC C2840556
J25: K1; TerminalBlock_4Ucon_1x03_P3.50mm_Horizontal; LCSC C695630
J26: K1; TerminalBlock_4Ucon_1x02_P3.50mm_Horizontal; LCSC C695629
J27: K2; TerminalBlock_4Ucon_1x03_P3.50mm_Horizontal; LCSC C695630
J28: K2; TerminalBlock_4Ucon_1x02_P3.50mm_Horizontal; LCSC C695629
K1, K2: G2RL-24 DC5; Relay_DPDT_Omron_G2RL-2; LCSC C6866153
Q16, Q17: Q_NPN_BEC; SOT-23; LCSC C460141
Q19, Q20, Q21, Q22: PMOS_30V_5.5A; SOT-23; LCSC C105162
R105, R140, R141, R142: 10k 0603; R_0603_1608Metric; LCSC C2930027
R136, R138: 4k7 0603; R_0603_1608Metric; LCSC C99782
R137, R139: 1.2k 0603; R_0603_1608Metric; LCSC C114605
R161, R162, R163, R164: 470R 0603; R_0603_1608Metric; LCSC C23179

Connections:
+12V: F10.1, F11.1, F12.2, F13.2, F14.2, F15.2, R105.1, R140.1, R141.1, R142.1; also elsewhere on the board
GND: D30.2 (A), D32.2 (A), J26.2, J28.2, Q16.2 (E), Q17.2 (E), R137.2, R139.2; also elsewhere on the board
unnamed: D29.2 (A), K1.A2, Q16.3 (C)
unnamed: D29.1 (K), F32.1, K1.A1
unnamed: D30.1 (K), J26.1, K1.14
unnamed: D31.2 (A), K2.A2, Q17.3 (C)
unnamed: D31.1 (K), F33.1, K2.A1
unnamed: D32.1 (K), J28.1, K2.14
unnamed: F10.2, K1.11
unnamed: F11.2, K2.11
unnamed: J25.1, K1.22
unnamed: J25.2, K1.24
unnamed: J25.3, K1.21
unnamed: J27.1, K2.22
unnamed: J27.2, K2.24
unnamed: J27.3, K2.21
unnamed: Q16.1 (B), R136.2, R137.1
unnamed: Q17.1 (B), R138.2, R139.1
unnamed: Q19.1 (G), R105.2, R161.1
unnamed: F12.1, Q19.2 (S)
unnamed: Q20.1 (G), R140.2, R162.1
unnamed: F13.1, Q20.2 (S)
unnamed: Q21.1 (G), R141.2, R163.1
unnamed: F14.1, Q21.2 (S)
unnamed: Q22.1 (G), R142.2, R164.1
unnamed: F15.1, Q22.2 (S)
RELAY_1_GPIO: R136.1; also elsewhere on the board
RELAY_2_GPIO: R138.1; also elsewhere on the board
SW1: R161.2; also elsewhere on the board
SW1-OUT: Q19.3 (D); also elsewhere on the board
SW2: R162.2; also elsewhere on the board
SW2-OUT: Q20.3 (D); also elsewhere on the board
SW3: R163.2; also elsewhere on the board
SW3-OUT: Q21.3 (D); also elsewhere on the board
SW4: R164.2; also elsewhere on the board
SW4-OUT: Q22.3 (D); also elsewhere on the board
VBUS: F32.2, F33.2; also elsewhere on the board

Notes on the sheet:
1-NC 2-NO 3-COM
1-24V 2-GND

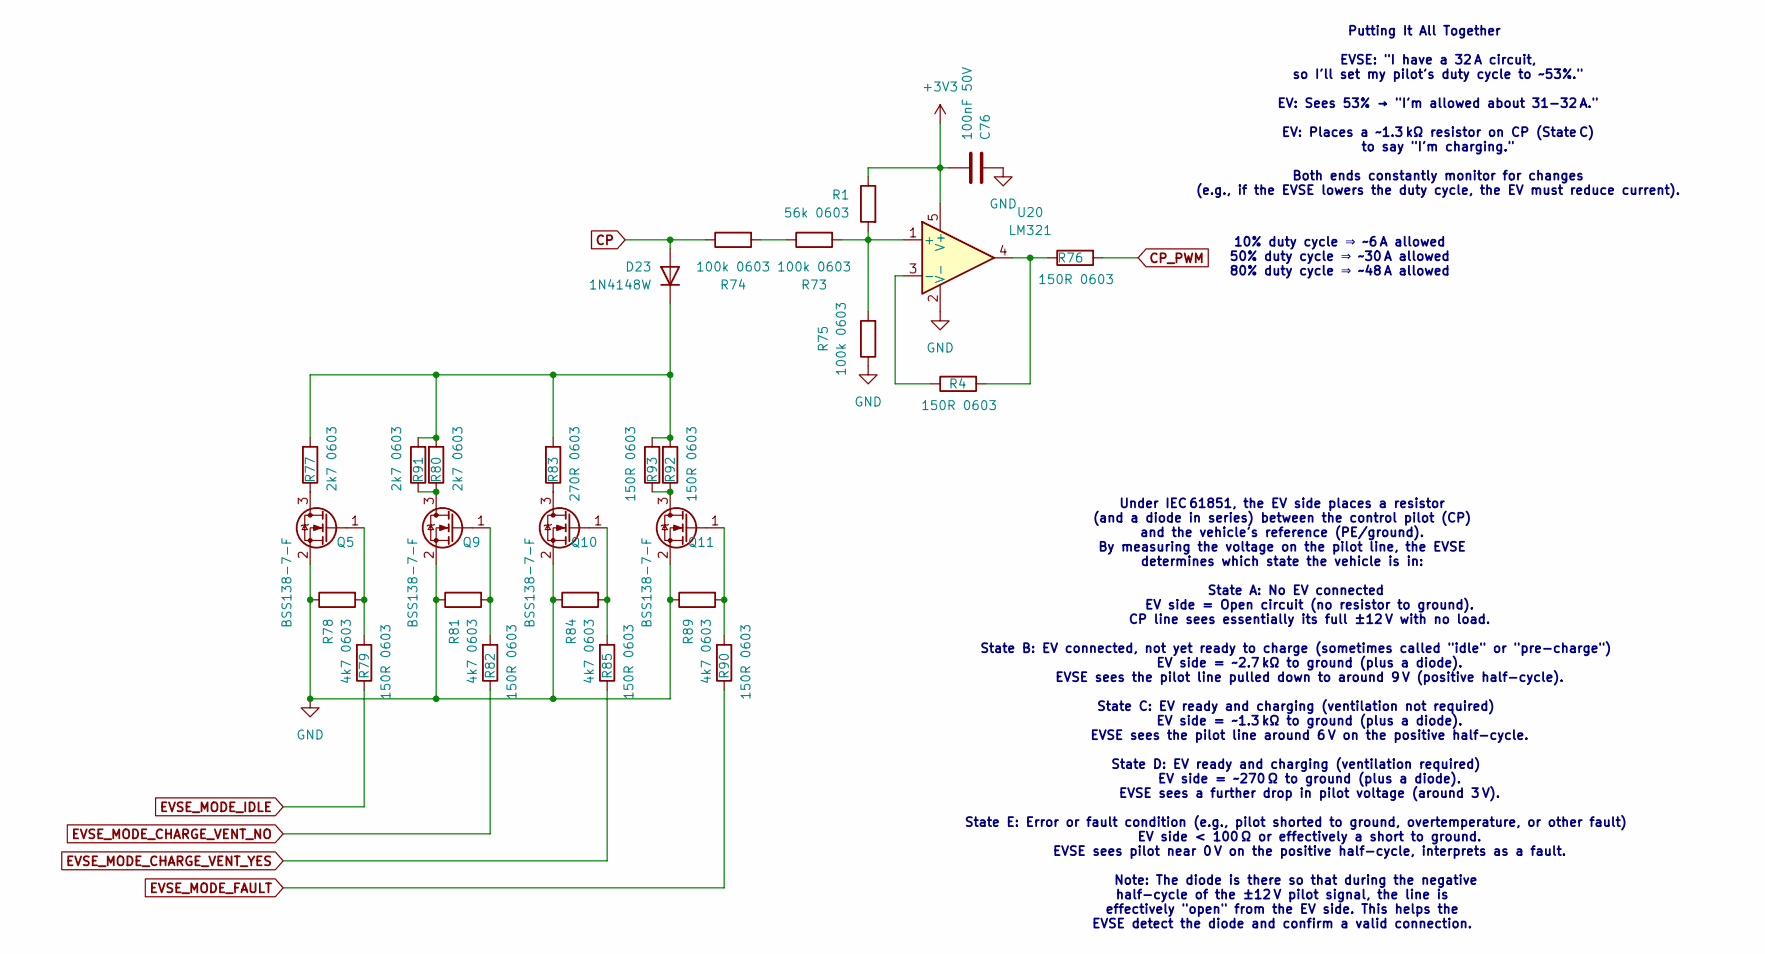
[picture p19: schematic type2.kicad_sch, VehicleMan]

Parts:
C76: 100nF 50V; C_0603_1608Metric; LCSC C14663
D23: 1N4148W; D_SOD-123; LCSC C917030
Q5, Q9, Q10, Q11: BSS138-7-F; SOT-23; LCSC C40912
R1: 56k 0603; R_0603_1608Metric; LCSC C23206
R4, R76, R79, R82, R85, R90, R92, R93: 150R 0603; R_0603_1608Metric; LCSC C2907103
R73, R74, R75: 100k 0603; R_0603_1608Metric; LCSC C14675
R77, R80, R91: 2k7 0603; R_0603_1608Metric; LCSC C13167
R78, R81, R84, R89: 4k7 0603; R_0603_1608Metric; LCSC C99782
R83: 270R 0603; R_0603_1608Metric; LCSC C22966
U20: LM321; SOT-23-5; LCSC C668208

Connections:
+3V3: C76.2, R1.1, U20.5 (V+); also elsewhere on the board
CP: D23.2 (A), R74.1; also elsewhere on the board
CP_PWM: R76.2; also elsewhere on the board
EVSE_MODE_CHARGE_VENT_NO: R82.1
EVSE_MODE_CHARGE_VENT_YES: R85.1
EVSE_MODE_FAULT: R90.1
EVSE_MODE_IDLE: R79.1
GND: C76.1, Q5.2 (S), Q9.2 (S), Q10.2 (S), Q11.2 (S), R75.1, R78.1, R81.1, R84.1, R89.1, U20.2 (V-); also elsewhere on the board
unnamed: D23.1 (K), R77.2, R80.2, R83.2, R91.2, R92.2, R93.2
unnamed: Q5.3 (D), R77.1
unnamed: Q5.1 (G), R78.2, R79.2
unnamed: Q9.3 (D), R80.1, R91.1
unnamed: Q9.1 (G), R81.2, R82.2
unnamed: Q10.3 (D), R83.1
unnamed: Q10.1 (G), R84.2, R85.2
unnamed: Q11.3 (D), R92.1, R93.1
unnamed: Q11.1 (G), R89.2, R90.2
unnamed: R4.2, R76.1, U20.4
unnamed: R73.1, R74.2
unnamed: R1.2, R73.2, R75.2, U20.1 (+)
unnamed: R4.1, U20.3 (-)

Notes on the sheet:
Under IEC 61851, the EV side places a resistor (and a diode in series) between the control pilot (CP) and the vehicle's reference (PE/ground). By measuring the voltage on the pilot line, the EVSE determines which state the vehicle is in: State A: No EV connected EV side = Open circuit (no resistor 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
10% duty cycle ⇒ ~6 A allowed 50% duty cycle ⇒ ~30 A allowed 80% duty cycle ⇒ ~48 A allowed
Putting It All Together EVSE: "I have a 32 A circuit, so I'll set my pilot's duty cycle to ~53%." EV: Sees 53% → "I'm allowed about 31-32 A." EV: Places a ~1.3 kΩ resistor on CP (State C) to say "I'm charging." Both ends constantly monitor for changes (e.g., if the EVSE lowers the duty cycle, the E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

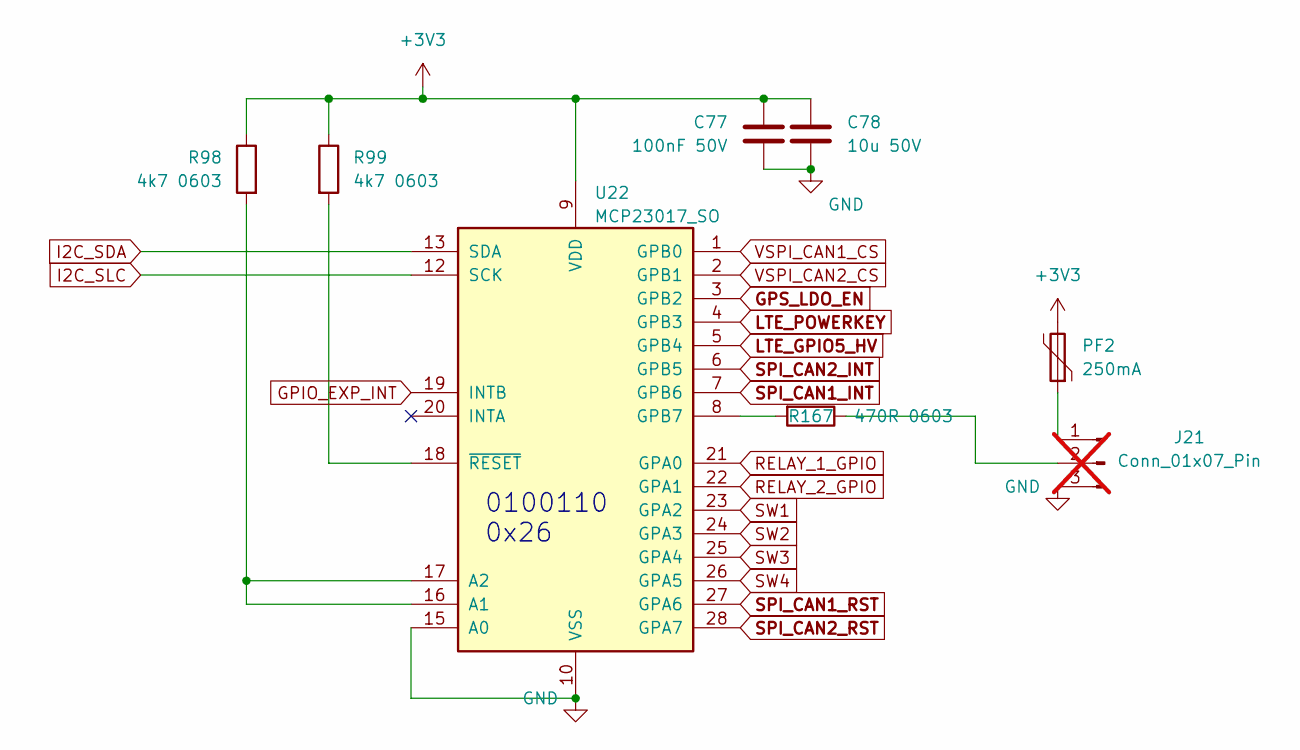
[picture p20: schematic GPIO_Expander.kicad_sch, VehicleMan]

Parts:
C77: 100nF 50V; C_0603_1608Metric; LCSC C14663
C78: 10u 50V; C_1206_3216Metric; LCSC C13585
J21: Conn_01x07_Pin; PinHeader_1x03_P1.27mm_Vertical; not fitted
PF2: 250mA; Fuse_1206_3216Metric; LCSC C70065
R98, R99: 4k7 0603; R_0603_1608Metric; LCSC C99782
R167: 470R 0603; R_0603_1608Metric; LCSC C23179
U22: MCP23017_SO; SOIC-28W_7.5x17.9mm_P1.27mm; LCSC C629440

Connections:
+3V3: C77.1, C78.1, PF2.2, R98.1, R99.1, U22.9 (VDD); also elsewhere on the board
GND: C77.2, C78.2, J21.3, U22.10 (VSS), U22.15 (A0); also elsewhere on the board
GPIO_EXP_INT: U22.19 (INTB); also elsewhere on the board
GPS_LDO_EN: U22.3 (GPB2); also elsewhere on the board
I2C_SDA: U22.13 (SDA); also elsewhere on the board
I2C_SLC: U22.12 (SCK); also elsewhere on the board
LTE_GPIO5_HV: U22.5 (GPB4); also elsewhere on the board
LTE_POWERKEY: U22.4 (GPB3); also elsewhere on the board
unnamed: J21.1, PF2.1
unnamed: J21.2, R167.1
unnamed: R98.2, U22.16 (A1), U22.17 (A2)
unnamed: R167.2, U22.8 (GPB7)
unnamed: R99.2, U22.18 (~RESET)
RELAY_1_GPIO: U22.21 (GPA0); also elsewhere on the board
RELAY_2_GPIO: U22.22 (GPA1); also elsewhere on the board
SPI_CAN1_INT: U22.7 (GPB6); also elsewhere on the board
SPI_CAN1_RST: U22.27 (GPA6); also elsewhere on the board
SPI_CAN2_INT: U22.6 (GPB5); also elsewhere on the board
SPI_CAN2_RST: U22.28 (GPA7); also elsewhere on the board
SW1: U22.23 (GPA2); also elsewhere on the board
SW2: U22.24 (GPA3); also elsewhere on the board
SW3: U22.25 (GPA4); also elsewhere on the board
SW4: U22.26 (GPA5); also elsewhere on the board
VSPI_CAN1_CS: U22.1 (GPB0); also elsewhere on the board
VSPI_CAN2_CS: U22.2 (GPB1); also elsewhere on the board

Notes on the sheet:
0100110 0x26

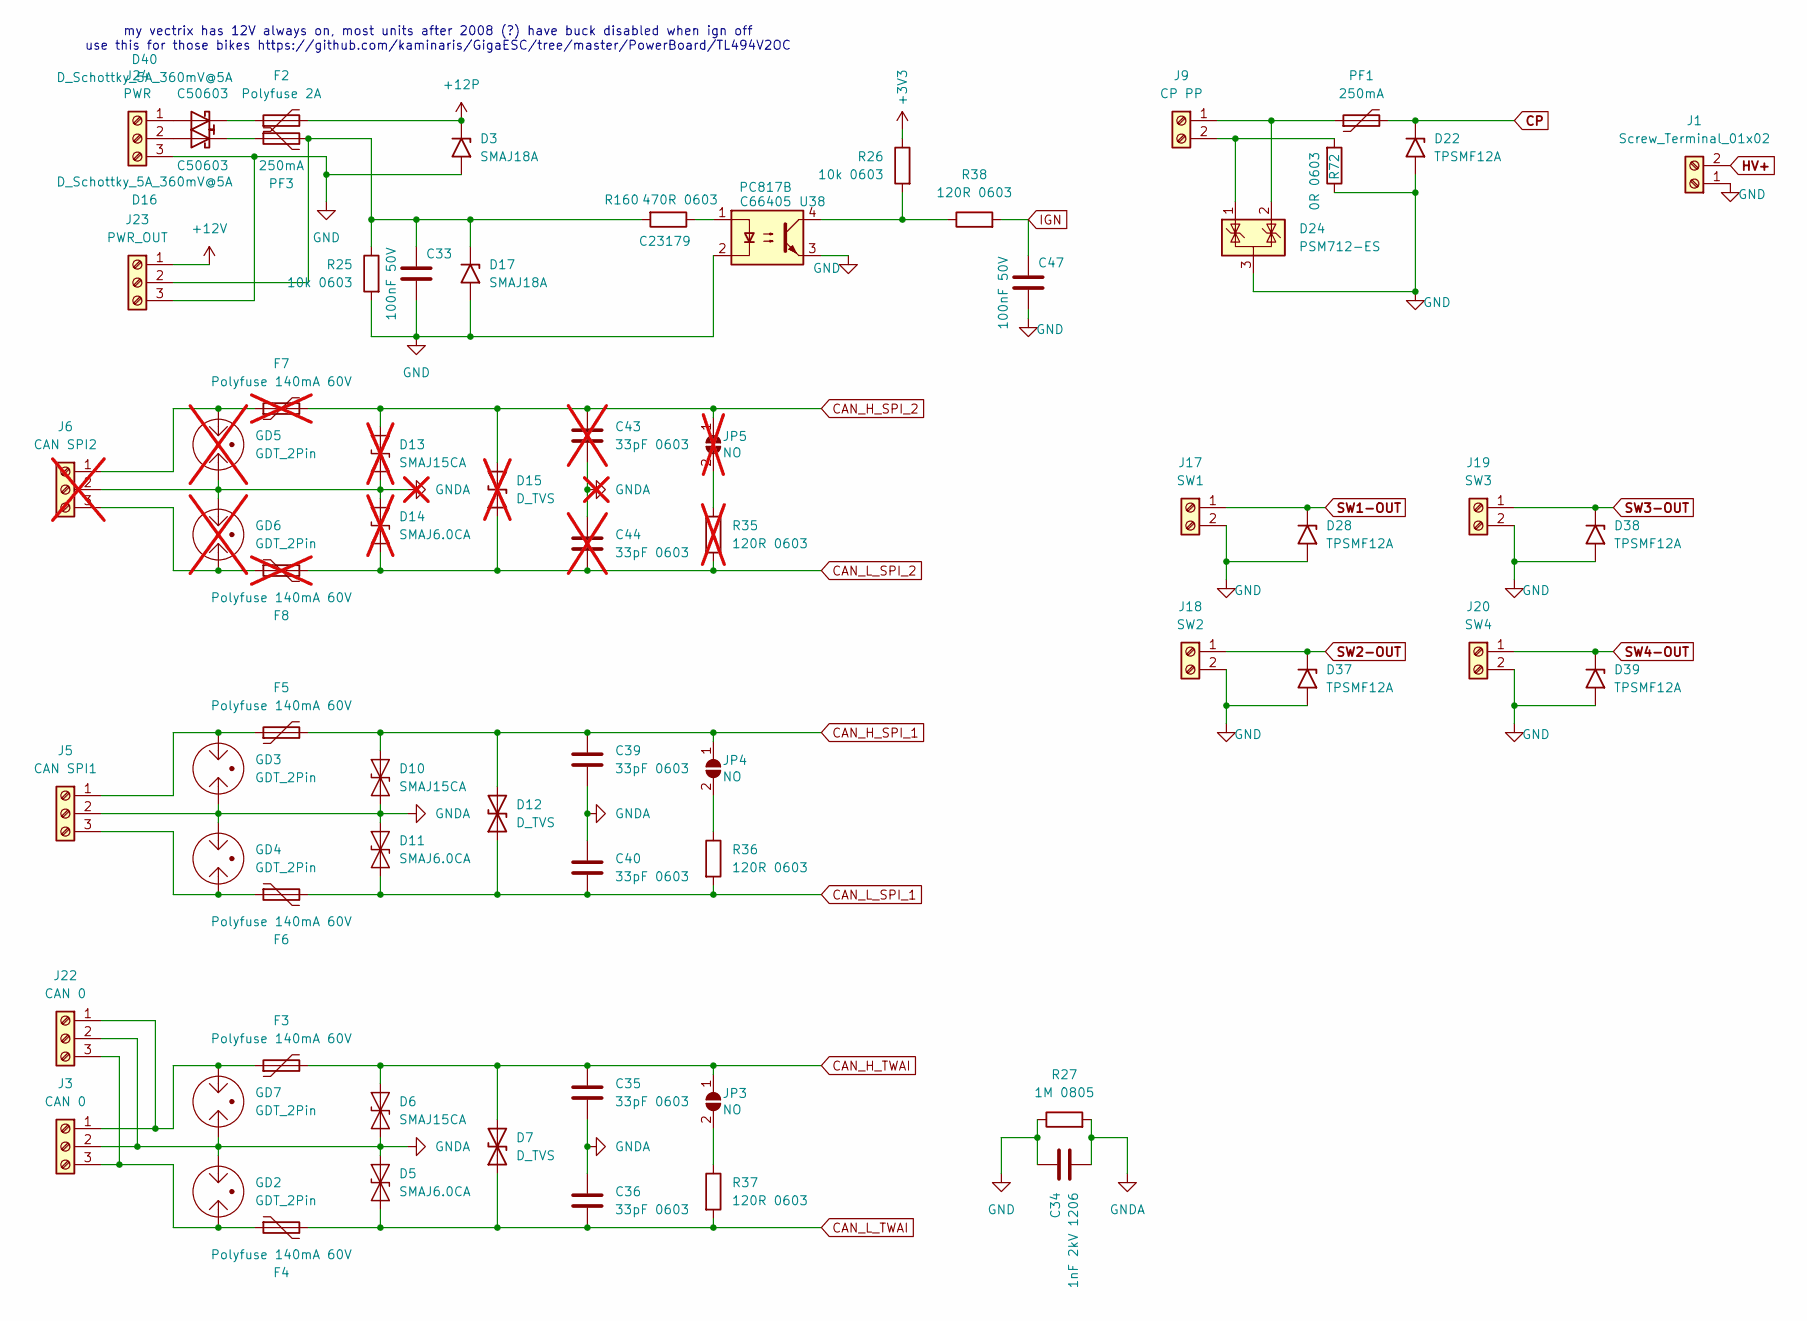
[picture p21: schematic conn.kicad_sch, VehicleMan]

Parts:
C33, C47: 100nF 50V; C_0603_1608Metric; LCSC C14663
C34: 1nF 2kV 1206; C_1206_3216Metric; LCSC C9196
C35, C36, C39, C40: 33pF 0603; C_0603_1608Metric; LCSC C107047
C43, C44: 33pF 0603; C_0603_1608Metric; LCSC C107047; not fitted
D3, D17: SMAJ18A; D_SMA
D5, D11: SMAJ6.0CA; D_SMA; LCSC C134999
D6, D10: SMAJ15CA; D_SMA; LCSC C2848698
D7, D12: D_TVS; D_SOD-323; LCSC C41409313
D13: SMAJ15CA; D_SMA; LCSC C2848698; not fitted
D14: SMAJ6.0CA; D_SMA; LCSC C134999; not fitted
D15: D_TVS; D_SOD-323; LCSC C41409313; not fitted
D16, D40: D_Schottky_5A_360mV@5A; D_SOD-128; LCSC C50603
D22, D28, D37, D38, D39: TPSMF12A; D_SOD-123; LCSC C42440530
D24: PSM712-ES; SOT-23; LCSC C5180294
F2: Polyfuse 2A; Fuse_2920_7451Metric; LCSC C6165181
F3, F4, F5, F6: Polyfuse 140mA 60V; Fuse_1812_4532Metric; LCSC C20994
F7, F8: Polyfuse 140mA 60V; Fuse_1812_4532Metric; LCSC C20994; not fitted
GD2, GD3, GD4, GD7: GDT_2Pin; Fuse_1812_4532Metric; LCSC C9235
GD5, GD6: GDT_2Pin; Fuse_1812_4532Metric; LCSC C9235; not fitted
J1: Screw_Terminal_01x02; TerminalBlock_Phoenix_MKDS-1,5-2-5.08_1x02_P5.08mm_Horizont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; LCSC C8465
J3, J22: CAN 0; TerminalBlock_4Ucon_1x03_P3.50mm_Horizontal; LCSC C695630
J5: CAN SPI1; TerminalBlock_4Ucon_1x03_P3.50mm_Horizontal; LCSC C695630
J6: CAN SPI2; TerminalBlock_4Ucon_1x03_P3.50mm_Horizontal; LCSC C695630; not fitted
J9: CP PP; TerminalBlock_4Ucon_1x02_P3.50mm_Horizontal; LCSC C695629
J17: SW1; TerminalBlock_4Ucon_1x02_P3.50mm_Horizontal; LCSC C695629
J18: SW2; TerminalBlock_4Ucon_1x02_P3.50mm_Horizontal; LCSC C695629
J19: SW3; TerminalBlock_4Ucon_1x02_P3.50mm_Horizontal; LCSC C695629
J20: SW4; TerminalBlock_4Ucon_1x02_P3.50mm_Horizontal; LCSC C695629
J23: PWR_OUT; TerminalBlock_4Ucon_1x03_P3.50mm_Horizontal; LCSC C695630
J24: PWR; TerminalBlock_4Ucon_1x03_P3.50mm_Horizontal; LCSC C695630
JP3, JP4: NO; SolderJumper-2_P1.3mm_Open_TrianglePad1.0x1.5mm
JP5: NO; SolderJumper-2_P1.3mm_Open_TrianglePad1.0x1.5mm; not fitted
PF1, PF3: 250mA; Fuse_1206_3216Metric; LCSC C70065
R25, R26: 10k 0603; R_0603_1608Metric; LCSC C2930027
R27: 1M 0805; R_0805_2012Metric; LCSC C17514
R35: 120R 0603; R_0603_1608Metric; LCSC C22787; not fitted
R36, R37, R38: 120R 0603; R_0603_1608Metric; LCSC C22787
R72: 0R 0603; R_0603_1608Metric; LCSC C21189
R160: 470R 0603; R_0603_1608Metric; LCSC C23179
U38: PC817B; SMDIP-4_W7.62mm; LCSC C66405

Connections:
+3V3: R26.1; also elsewhere on the board
+12P: D3.1 (A1), F2.2; also elsewhere on the board
+12V: J23.1; also elsewhere on the board
CAN_H_SPI_1: C39.1, D10.2 (A2), D12.2 (A2), F5.2, JP4.1 (A); also elsewhere on the board
CAN_H_SPI_2: C43.1, D13.2 (A2), D15.2 (A2), F7.2, JP5.1 (A); also elsewhere on the board
CAN_H_TWAI: C35.1, D6.2 (A2), D7.2 (A2), F3.2, JP3.1 (A); also elsewhere on the board
CAN_L_SPI_1: C40.2, D11.1 (A1), D12.1 (A1), F6.2, R36.2; also elsewhere on the board
CAN_L_SPI_2: C44.2, D14.1 (A1), D15.1 (A1), F8.2, R35.2; also elsewhere on the board
CAN_L_TWAI: C36.2, D5.1 (A1), D7.1 (A1), F4.2, R37.2; also elsewhere on the board
CP: D22.1 (A1), PF1.2; also elsewhere on the board
GND: C33.2, C34.1, C47.2, D3.2 (A2), D17.2 (A2), D22.2 (A2), D24.3 (A), D28.2 (A2), D37.2 (A2), D38.2 (A2), D39.2 (A2), J1.1, J17.2, J18.2, J19.2, J20.2, J23.3, J24.3, R25.2, R27.1, R72.1, U38.2, U38.3; also elsewhere on the board
GNDA: C34.2, C35.2, C36.1, C39.2, C40.1, C43.2, C44.1, D5.2 (A2), D6.1 (A1), D10.1 (A1), D11.2 (A2), D13.1 (A1), D14.2 (A2), GD2.2, GD3.1, GD4.2, GD5.1, GD6.2, GD7.1, J3.2, J5.2, J6.2, J22.2, R27.2
HV+: J1.2; also elsewhere on the board
IGN: C47.1, R38.2; also elsewhere on the board
unnamed: D16.2 (A), J24.2
unnamed: D16.1 (K), PF3.1
unnamed: C33.1, D17.1 (A1), J23.2, PF3.2, R25.1, R160.2
unnamed: D40.2 (A), J24.1
unnamed: D40.1 (K), F2.1
unnamed: F5.1, GD3.2, J5.1
unnamed: F6.1, GD4.1, J5.3
unnamed: F7.1, GD5.2, J6.1
unnamed: F8.1, GD6.1, J6.3
unnamed: D24.2 (K), J9.1, PF1.1
unnamed: D24.1 (K), J9.2, R72.2
unnamed: F3.1, GD7.2, J3.1, J22.1
unnamed: F4.1, GD2.1, J3.3, J22.3
unnamed: JP3.2 (B), R37.1
unnamed: JP4.2 (B), R36.1
unnamed: JP5.2 (B), R35.1
unnamed: R26.2, R38.1, U38.4
unnamed: R160.1, U38.1
SW1-OUT: D28.1 (A1), J17.1; also elsewhere on the board
SW2-OUT: D37.1 (A1), J18.1; also elsewhere on the board
SW3-OUT: D38.1 (A1), J19.1; also elsewhere on the board
SW4-OUT: D39.1 (A1), J20.1; also elsewhere on the board

Notes on the sheet:
my vectrix has 12V always on, most units after 2008 (?) have buck disabled when ign off use this for those bikes https://github.com/kaminaris/GigaESC/tree/master/PowerBoard/TL494V2OC
