skrubis/vectrix-vehicleman/kicad/vectrix-vehicleman-0.kicad_pcb

## KiCad design kicad/vectrix-vehicleman-0.kicad_pcb (continued)

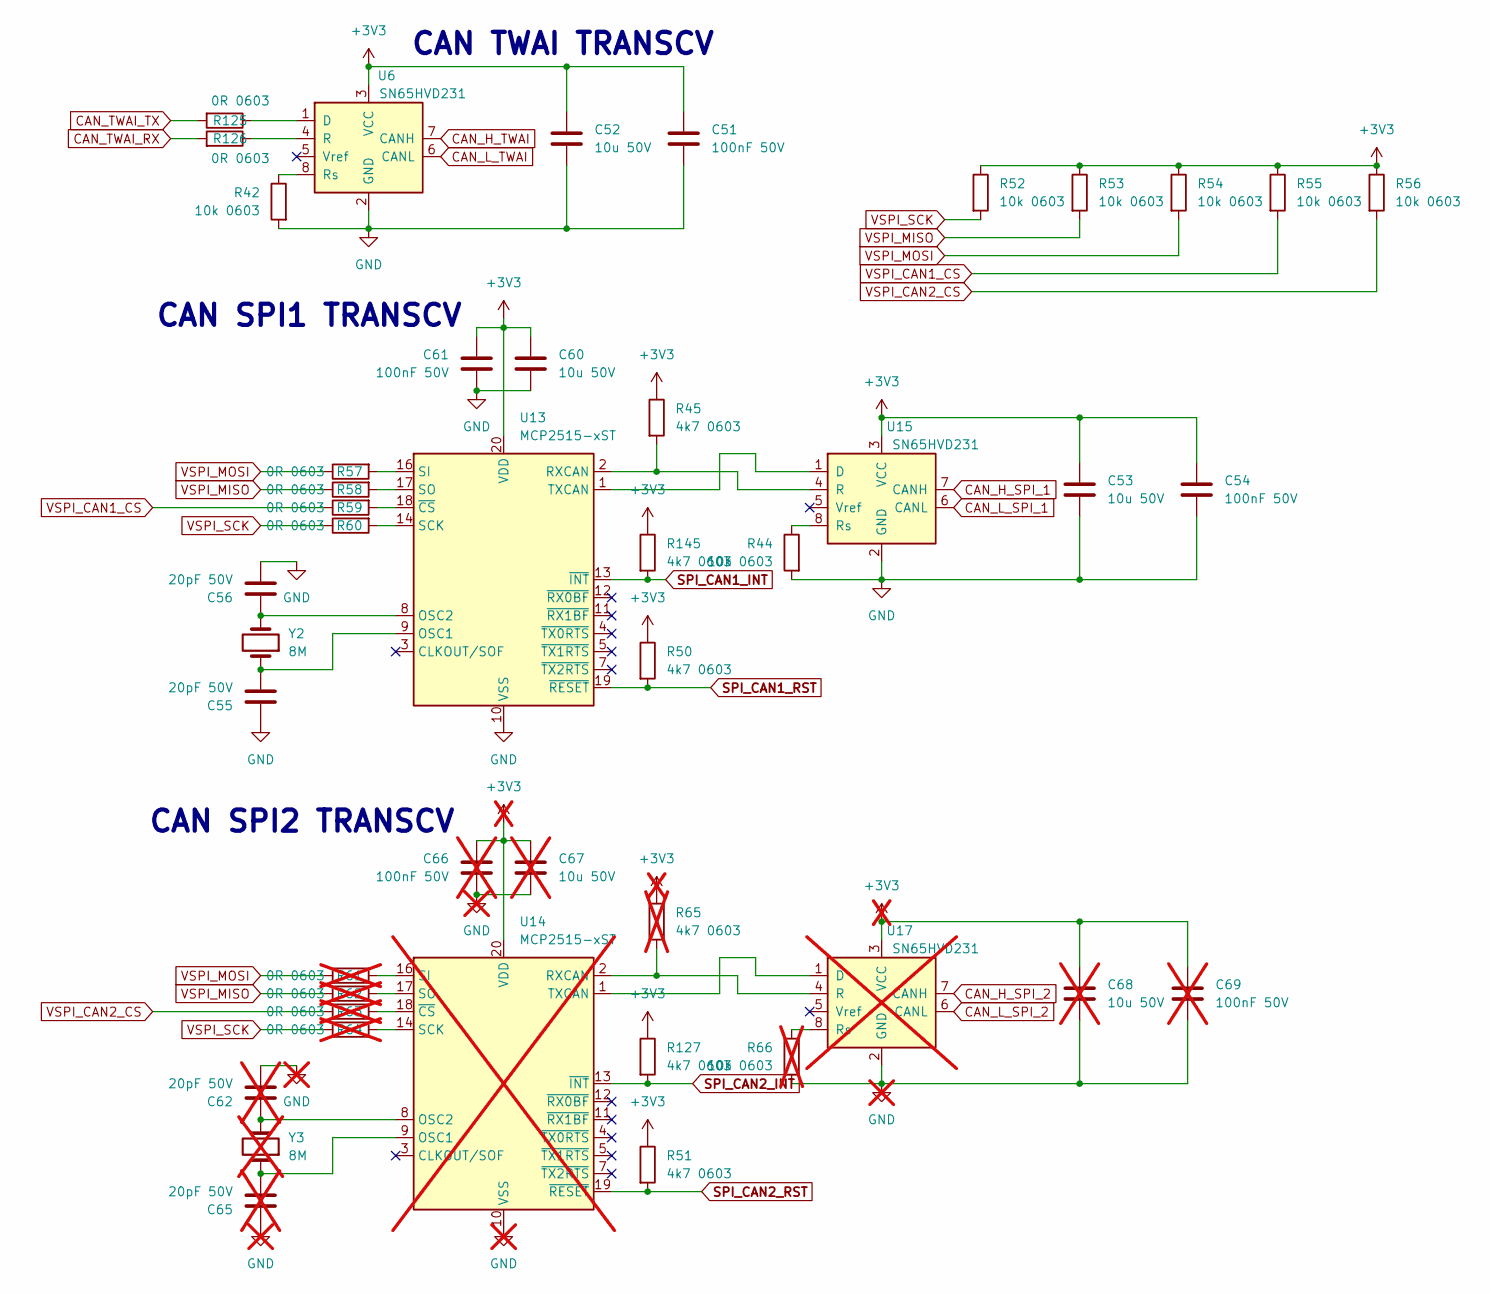
[picture p22: schematic CAN.kicad_sch, VehicleMan]

Parts:
C51, C54, C61: 100nF 50V; C_0603_1608Metric; LCSC C14663
C52, C53, C60: 10u 50V; C_1206_3216Metric; LCSC C13585
C55, C56: 20pF 50V; C_0603_1608Metric; LCSC C105621
C62, C65: 20pF 50V; C_0603_1608Metric; LCSC C105621; not fitted
C66, C69: 100nF 50V; C_0603_1608Metric; LCSC C14663; not fitted
C67, C68: 10u 50V; C_1206_3216Metric; LCSC C13585; not fitted
R42, R44, R52, R53, R54, R55, R56: 10k 0603; R_0603_1608Metric; LCSC C2930027
R45, R50, R51, R127, R145: 4k7 0603; R_0603_1608Metric; LCSC C99782
R57, R58, R59, R60, R125, R126: 0R 0603; R_0603_1608Metric; LCSC C21189
R61, R62, R63, R64: 0R 0603; R_0603_1608Metric; LCSC C21189; not fitted
R65: 4k7 0603; R_0603_1608Metric; LCSC C99782; not fitted
R66: 10k 0603; R_0603_1608Metric; LCSC C2930027; not fitted
U6, U15: SN65HVD231; SOIC-8_3.9x4.9mm_P1.27mm; LCSC C12084
U13: MCP2515-xST; TSSOP-20_4.4x6.5mm_P0.65mm; LCSC C185941
U14: MCP2515-xST; TSSOP-20_4.4x6.5mm_P0.65mm; LCSC C185941; not fitted
U17: SN65HVD231; SOIC-8_3.9x4.9mm_P1.27mm; LCSC C12084; not fitted
Y2: 8M; Crystal_SMD_HC49-SD
Y3: 8M; Crystal_SMD_HC49-SD; not fitted

Connections:
+3V3: C51.1, C52.1, C53.1, C54.1, C60.1, C61.1, C66.1, C67.1, C68.1, C69.1, R45.1, R50.1, R51.1, R52.1, R53.1, R54.1, R55.1, R56.1, R65.1, R127.1, R145.1, U6.3 (VCC), U13.20 (VDD), U14.20 (VDD), U15.3 (VCC), U17.3 (VCC); also elsewhere on the board
CAN_H_SPI_1: U15.7 (CANH); also elsewhere on the board
CAN_H_SPI_2: U17.7 (CANH); also elsewhere on the board
CAN_H_TWAI: U6.7 (CANH); also elsewhere on the board
CAN_L_SPI_1: U15.6 (CANL); also elsewhere on the board
CAN_L_SPI_2: U17.6 (CANL); also elsewhere on the board
CAN_L_TWAI: U6.6 (CANL); also elsewhere on the board
CAN_TWAI_RX: R126.2; also elsewhere on the board
CAN_TWAI_TX: R125.2; also elsewhere on the board
GND: C51.2, C52.2, C53.2, C54.2, C55.1, C56.2, C60.2, C61.2, C62.2, C65.1, C66.2, C67.2, C68.2, C69.2, R42.2, R44.2, R66.2, U6.2 (GND), U13.10 (VSS), U14.10 (VSS), U15.2 (GND), U17.2 (GND); also elsewhere on the board
unnamed: R125.1, U6.1 (D)
unnamed: R126.1, U6.4 (R)
unnamed: R42.1, U6.8 (Rs)
unnamed: C55.2, U13.9 (OSC1), Y2.1
unnamed: C56.1, U13.8 (OSC2), Y2.2
unnamed: R45.2, U13.2 (RXCAN), U15.4 (R)
unnamed: R60.2, U13.14 (SCK)
unnamed: R57.2, U13.16 (SI)
unnamed: R58.2, U13.17 (SO)
unnamed: U13.1 (TXCAN), U15.1 (D)
unnamed: R59.2, U13.18 (~CS)
unnamed: C65.2, U14.9 (OSC1), Y3.1
unnamed: C62.1, U14.8 (OSC2), Y3.2
unnamed: R65.2, U14.2 (RXCAN), U17.4 (R)
unnamed: R64.2, U14.14 (SCK)
unnamed: R61.2, U14.16 (SI)
unnamed: R62.2, U14.17 (SO)
unnamed: U14.1 (TXCAN), U17.1 (D)
unnamed: R63.2, U14.18 (~CS)
unnamed: R44.1, U15.8 (Rs)
unnamed: R66.1, U17.8 (Rs)
SPI_CAN1_INT: R145.2, U13.13 (~INT); also elsewhere on the board
SPI_CAN1_RST: R50.2, U13.19 (~RESET); also elsewhere on the board
SPI_CAN2_INT: R127.2, U14.13 (~INT); also elsewhere on the board
SPI_CAN2_RST: R51.2, U14.19 (~RESET); also elsewhere on the board
VSPI_CAN1_CS: R55.2, R59.1; also elsewhere on the board
VSPI_CAN2_CS: R56.2, R63.1; also elsewhere on the board
VSPI_MISO: R53.2, R58.1, R62.1; also elsewhere on the board
VSPI_MOSI: R54.2, R57.1, R61.1; also elsewhere on the board
VSPI_SCK: R52.2, R60.1, R64.1; also elsewhere on the board

Notes on the sheet:
CAN SPI2 TRANSCV
CAN SPI1 TRANSCV
CAN TWAI TRANSCV

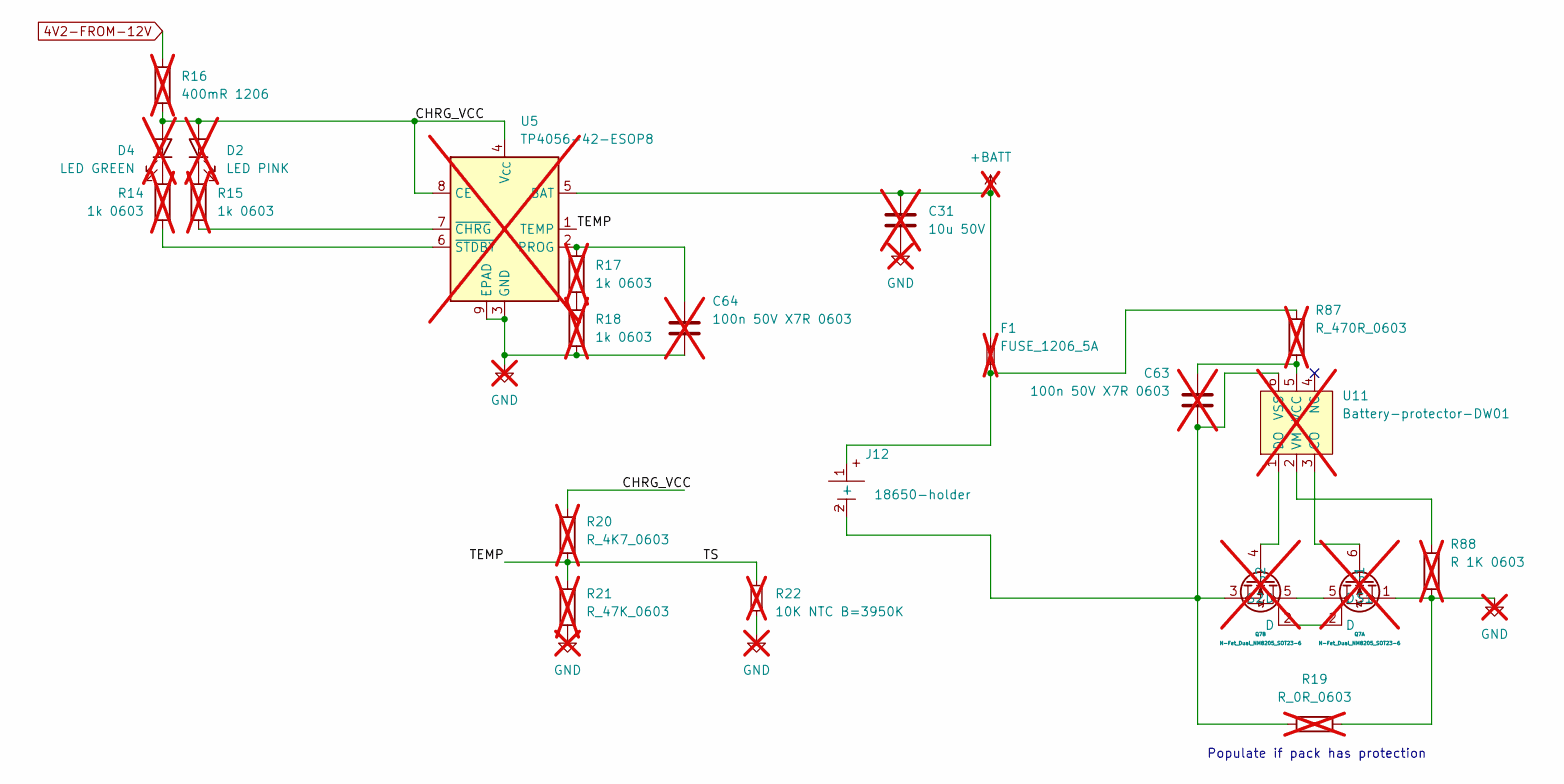
[picture p23: schematic battery-backup.kicad_sch, VehicleMan]

Parts:
C31: 10u 50V; C_1206_3216Metric; LCSC C13585; not fitted
C63, C64: 100n 50V X7R 0603; C_0603_1608Metric; LCSC C314282; not fitted
D2: LED PINK; LED_0805_2012Metric; LCSC C965821; not fitted
D4: LED GREEN; LED_0805_2012Metric; LCSC C5875740; not fitted
F1: FUSE_1206_5A; Fuse_1206_3216Metric; LCSC C883136; not fitted
J12: 18650-holder; C5290175-18650-holder; LCSC C5290175
Q7: N-Fet_Dual_NM8205_SOT23-6; SOT-23-6; LCSC C5156806; not fitted
R14, R15, R17, R18: 1k 0603; R_0603_1608Metric; LCSC C2907113; not fitted
R16: 400mR 1206; R_1206_3216Metric; LCSC C912792; not fitted
R19: R_0R_0603; R_0603_1608Metric; LCSC C2907080; not fitted
R20: R_4K7_0603; R_0603_1608Metric; LCSC C23162; not fitted
R21: R_47K_0603; R_0603_1608Metric; LCSC C2907173; not fitted
R22: 10K NTC B=3950K; R_0603_1608Metric; LCSC C279936; not fitted
R87: R_470R_0603; R_0603_1608Metric; LCSC C2907172; not fitted
R88: R 1K 0603; R_0603_1608Metric; LCSC C25585; not fitted
U5: TP4056-42-ESOP8; SOIC-8-1EP_3.9x4.9mm_P1.27mm_EP2.41x3.3mm_ThermalVias; not fitted
U11: Battery-protector-DW01; SOT-23-6; LCSC C917079; not fitted

Connections:
4V2-FROM-12V: R16.1; also elsewhere on the board
+BATT: C31.1, F1.2, U5.5 (BAT); also elsewhere on the board
/Battery/CHRG_VCC: D2.2 (A), D4.2 (A), R16.2, R20.1, U5.4 (V_{CC}), U5.8 (CE)
/Battery/TEMP: R20.2, R21.1, R22.1, U5.1 (TEMP)
GND: C31.2, C64.2, Q7.1 (S1), R18.2, R19.2, R21.2, R22.2, R88.2, U5.3 (GND), U5.9 (EPAD); also elsewhere on the board
unnamed: D2.1 (K), R15.1
unnamed: D4.1 (K), R14.1
unnamed: F1.1, J12.1 (+), R87.1
unnamed: C63.2, J12.2 (-), Q7.3 (S2), R19.1, U11.6 (VSS)
unnamed: Q7.6 (G1), U11.3 (CO)
unnamed: Q7.4 (G2), U11.1 (DO)
unnamed: R17.2, R18.1
unnamed: C64.1, R17.1, U5.2 (PROG)
unnamed: R15.2, U5.7 (~CHRG)
unnamed: R14.2, U5.6 (~STDBY)
unnamed: C63.1, R87.2, U11.5 (VCC)
unnamed: R88.1, U11.2 (VM)

Notes on the sheet:
Populate if pack has protection

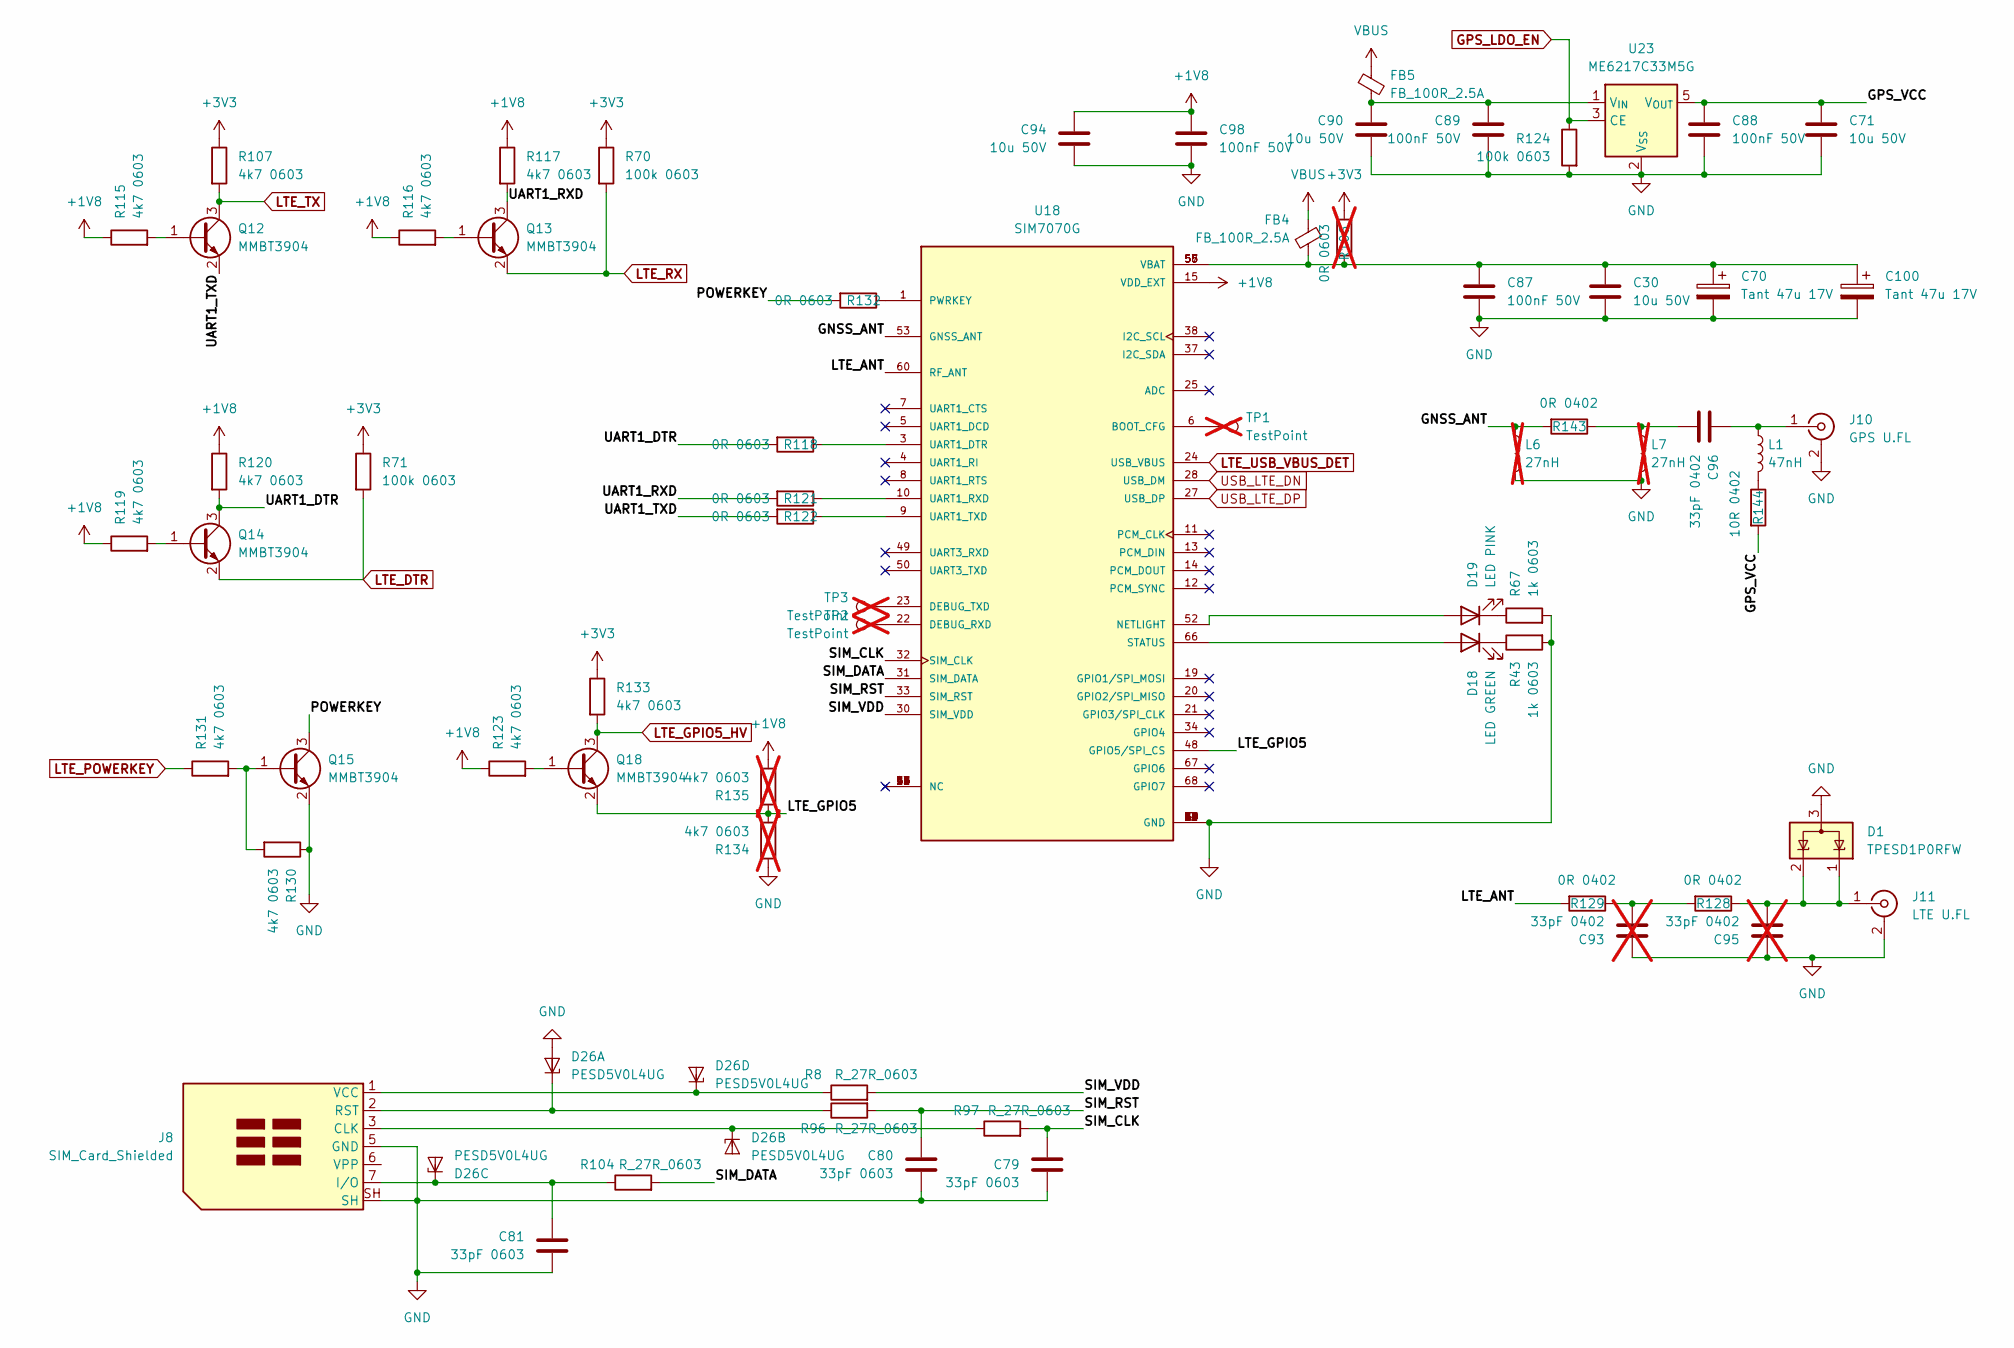
[picture p24: schematic LTE.kicad_sch, VehicleMan]

Parts:
C30, C71, C90, C94: 10u 50V; C_1206_3216Metric; LCSC C13585
C70, C100: Tant 47u 17V; CP_EIA-3528-12_Kemet-T; LCSC C136751
C79, C80, C81: 33pF 0603; C_0603_1608Metric; LCSC C107047
C87, C88, C89, C98: 100nF 50V; C_0603_1608Metric; LCSC C14663
C93, C95: 33pF 0402; C_0402_1005Metric; LCSC C1562; not fitted
C96: 33pF 0402; C_0402_1005Metric; LCSC C1562
D1: TPESD1P0RFW; SOT-323_SC-70; LCSC C521956
D18: LED GREEN; LED_0805_2012Metric; LCSC C5875740
D19: LED PINK; LED_0805_2012Metric; LCSC C965821
D26: PESD5V0L4UG; SOT-353_SC-70-5; LCSC C5116450
FB4, FB5: FB_100R_2.5A; L_0603_1608Metric; LCSC C96995
J8: SIM_Card_Shielded; nanoSIM_Hinged_CUI_NSIM-2-C; LCSC C266890
J10: GPS U.FL; U.FL_Hirose_U.FL-R-SMT-1_Vertical; LCSC C496552
J11: LTE U.FL; U.FL_Hirose_U.FL-R-SMT-1_Vertical; LCSC C496552
L1: 47nH; L_0402_1005Metric; LCSC C97998
L6, L7: 27nH; L_0402_1005Metric; LCSC C12669; not fitted
Q12, Q13, Q14, Q15, Q18: MMBT3904; SOT-23
R8, R96, R97, R104: R_27R_0603; R_0603_1608Metric; LCSC C101313
R43, R67: 1k 0603; R_0603_1608Metric; LCSC C2907113
R70, R71, R124: 100k 0603; R_0603_1608Metric; LCSC C14675
R106: 0R 0603; R_0603_1608Metric; LCSC C21189; not fitted
R107, R115, R116, R117, R119, R120, R123, R130, R131, R133: 4k7 0603; R_0603_1608Metric; LCSC C99782
R118, R121, R122, R132: 0R 0603; R_0603_1608Metric; LCSC C21189
R128, R129, R143: 0R 0402; R_0402_1005Metric; LCSC C106231
R134, R135: 4k7 0603; R_0603_1608Metric; LCSC C99782; not fitted
R144: 10R 0402; R_0402_1005Metric; LCSC C22859
TP1, TP2, TP3: TestPoint; TestPoint_Pad_D1.0mm; not fitted
U18: SIM7070G; LCSC C2892847
U23: ME6217C33M5G; SOT-23-5; LCSC C427602

Connections:
+1V8: C94.1, C98.1, R115.1, R116.1, R117.1, R119.1, R120.1, R123.1, R135.2, U18.15 (VDD_EXT)
+3V3: R70.1, R71.1, R106.2, R107.1, R133.1; also elsewhere on the board
/LTE/GNSS_ANT: L6.1, R143.2, U18.53 (GNSS_ANT)
/LTE/GPS_VCC: C71.1, C88.1, R144.2, U23.5 (V_{OUT})
/LTE/LTE_ANT: R129.2, U18.60 (RF_ANT)
/LTE/LTE_GPIO5: Q18.2 (E), R134.2, R135.1, U18.48 (GPIO5/SPI_CS)
/LTE/POWERKEY: Q15.3 (C), R132.2
/LTE/SIM_CLK: C79.1, R97.2, U18.32 (SIM_CLK)
/LTE/SIM_DATA: R104.2, U18.31 (SIM_DATA)
/LTE/SIM_RST: C80.1, R96.2, U18.33 (SIM_RST)
/LTE/SIM_VDD: R8.2, U18.30 (SIM_VDD)
/LTE/UART1_DTR: Q14.3 (C), R118.2, R120.2
/LTE/UART1_RXD: Q13.3 (C), R117.2, R121.2
/LTE/UART1_TXD: Q12.2 (E), R122.2
GND: C30.2, C70.2, C71.2, C79.2, C80.2, C81.2, C87.2, C88.2, C89.2, C90.2, C93.1, C94.2, C95.1, C98.2, C100.2, D1.3 (A), D26.2 (A), J8.5 (GND), J8.SH, J10.2 (Ext), J11.2 (Ext), L6.2, L7.2, Q15.2 (E), R43.2, R67.2, R124.2, R130.1, R134.1, U18.2 (GND), U18.17 (GND), U18.18 (GND), U18.29 (GND), U18.39 (GND), U18.45 (GND), U18.46 (GND), U18.54 (GND), U18.58 (GND), U18.59 (GND), U18.61 (GND), U18.62 (GND), U18.63 (GND), U18.64 (GND), U18.65 (GND), U23.2 (V_{SS}); also elsewhere on the board
GPS_LDO_EN: R124.1, U23.3 (CE); also elsewhere on the board
LTE_DTR: Q14.2 (E), R71.2; also elsewhere on the board
LTE_GPIO5_HV: Q18.3 (C), R133.2; also elsewhere on the board
LTE_POWERKEY: R131.1; also elsewhere on the board
LTE_RX: Q13.2 (E), R70.2; also elsewhere on the board
LTE_TX: Q12.3 (C), R107.2; also elsewhere on the board
LTE_USB_VBUS_DET: U18.24 (USB_VBUS); also elsewhere on the board
unnamed: C93.2, R128.2, R129.1
unnamed: C96.2, L7.1, R143.1
unnamed: C30.1, C70.1, C87.1, C100.1, FB4.1, R106.1, U18.55 (VBAT), U18.56 (VBAT), U18.57 (VBAT)
unnamed: D18.2 (A), U18.66 (STATUS)
unnamed: D18.1 (K), R43.1
unnamed: D19.2 (A), U18.52 (NETLIGHT)
unnamed: D19.1 (K), R67.1
unnamed: D26.1 (K1), J8.2 (RST), R96.1
unnamed: D26.3 (K2), J8.3 (CLK), R97.1
unnamed: C81.1, D26.4 (K3), J8.7 (I/O), R104.1
unnamed: D26.5 (K4), J8.1 (VCC), R8.1
unnamed: C96.1, J10.1 (In), L1.1
unnamed: C95.2, D1.1 (K), D1.2 (K), J11.1 (In), R128.1
unnamed: L1.2, R144.1
unnamed: Q12.1 (B), R115.2
unnamed: Q13.1 (B), R116.2
unnamed: Q14.1 (B), R119.2
unnamed: Q15.1 (B), R130.2, R131.2
unnamed: Q18.1 (B), R123.2
unnamed: TP1.1, U18.6 (BOOT_CFG)
unnamed: TP2.1, U18.22 (DEBUG_RXD)
unnamed: TP3.1, U18.23 (DEBUG_TXD)
unnamed: R132.1, U18.1 (PWRKEY)
unnamed: R118.1, U18.3 (UART1_DTR)
unnamed: R121.1, U18.10 (UART1_RXD)
unnamed: R122.1, U18.9 (UART1_TXD)
unnamed: C89.1, C90.1, FB5.2, U23.1 (V_{IN})
USB_LTE_DN: U18.28 (USB_DM); also elsewhere on the board
USB_LTE_DP: U18.27 (USB_DP); also elsewhere on the board
VBUS: FB4.2, FB5.1; also elsewhere on the board

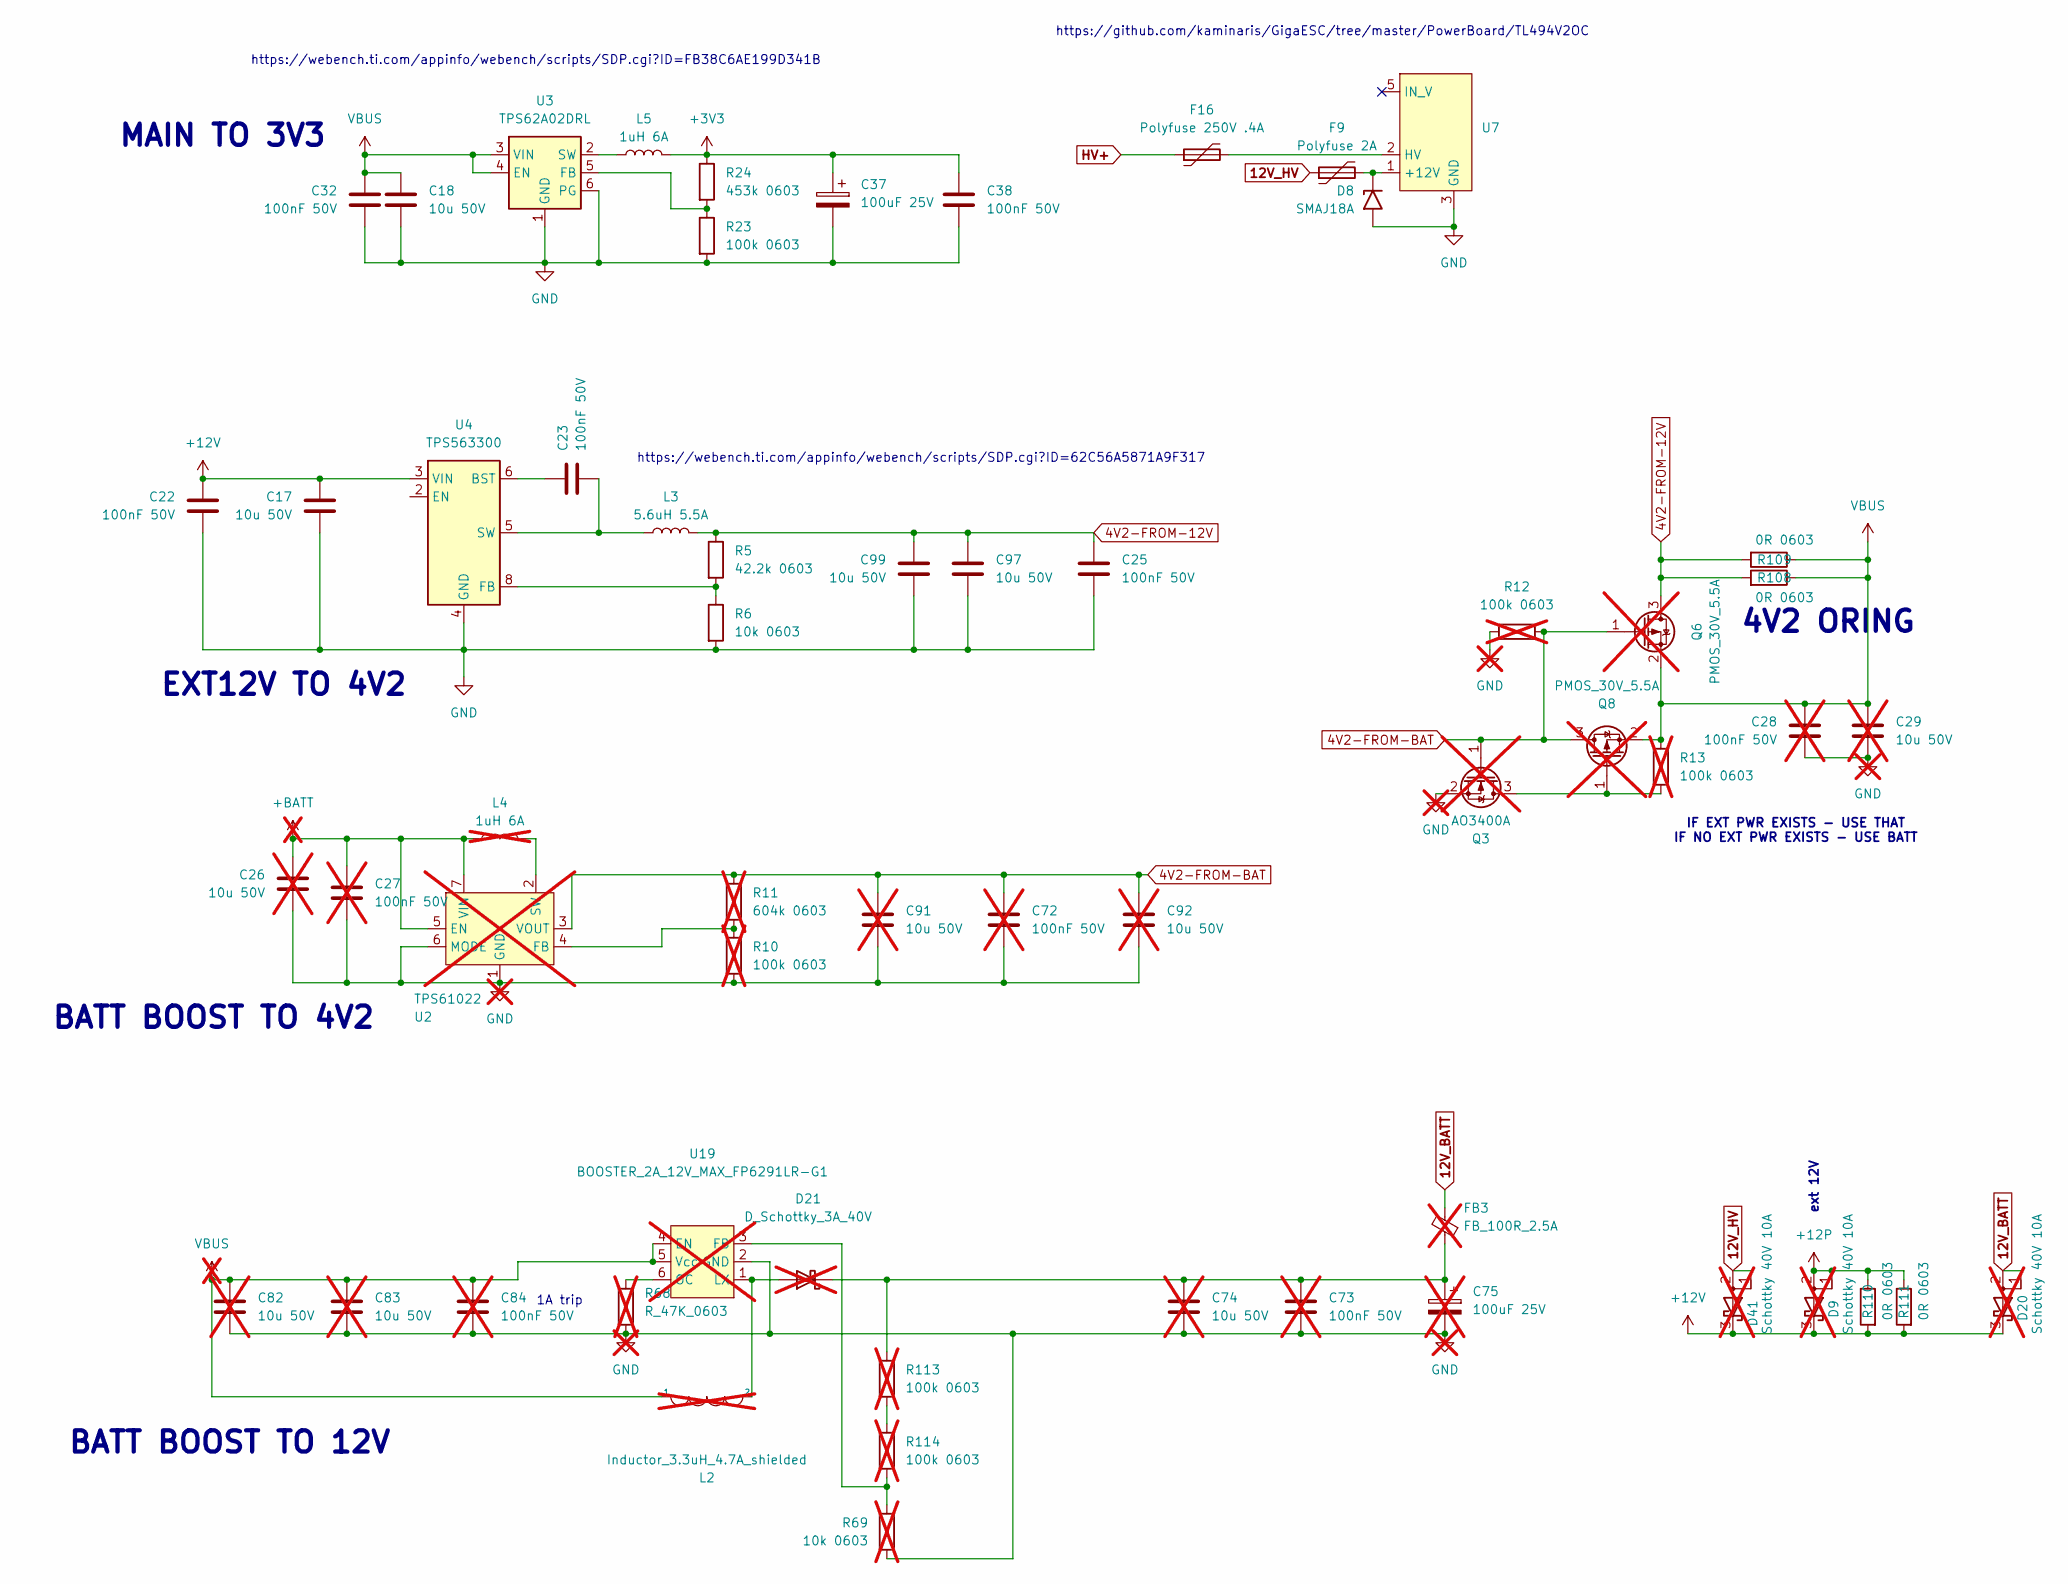
[picture p25: schematic DCDC.kicad_sch, VehicleMan]

Parts:
C17, C18, C97, C99: 10u 50V; C_1206_3216Metric; LCSC C13585
C22, C23, C25, C32, C38: 100nF 50V; C_0603_1608Metric; LCSC C14663
C26, C29, C74, C82, C83, C91, C92: 10u 50V; C_1206_3216Metric; LCSC C13585; not fitted
C27, C28, C72, C73, C84: 100nF 50V; C_0603_1608Metric; LCSC C14663; not fitted
C37: 100uF 25V; CP_Elec_6.3x7.7; LCSC C2918360
C75: 100uF 25V; CP_Elec_6.3x7.7; LCSC C2918360; not fitted
D8: SMAJ18A; D_SMA
D9, D20, D41: Schottky 40V 10A; TO-277B; LCSC C2988031; not fitted
D21: D_Schottky_3A_40V; D_SMA; LCSC C2758580; not fitted
F9: Polyfuse 2A; Fuse_2920_7451Metric; LCSC C6165181
F16: Polyfuse 250V .4A; Fuse_Bourns_MF-RHT200; LCSC C693579
FB3: FB_100R_2.5A; L_0603_1608Metric; LCSC C96995; not fitted
L2: Inductor_3.3uH_4.7A_shielded; L_7.3x7.3_H4.5; LCSC C216194; not fitted
L3: 5.6uH 5.5A; L_KOHERelec_MDA7030; LCSC C475914
L4: 1uH 6A; L_APV_APH0412; LCSC C167203; not fitted
L5: 1uH 6A; L_APV_APH0412; LCSC C167203
Q3: AO3400A; SOT-23; LCSC C347475; not fitted
Q6, Q8: PMOS_30V_5.5A; SOT-23; LCSC C105162; not fitted
R5: 42.2k 0603; R_0603_1608Metric; LCSC C5126245
R6: 10k 0603; R_0603_1608Metric; LCSC C2930027
R10, R12, R13, R113, R114: 100k 0603; R_0603_1608Metric; LCSC C14675; not fitted
R11: 604k 0603; R_0603_1608Metric; LCSC C2933246; not fitted
R23: 100k 0603; R_0603_1608Metric; LCSC C14675
R24: 453k 0603; R_0603_1608Metric; LCSC C27009
R68: R_47K_0603; R_0603_1608Metric; LCSC C2907173; not fitted
R69: 10k 0603; R_0603_1608Metric; LCSC C2930027; not fitted
R108, R109, R110, R111: 0R 0603; R_0603_1608Metric; LCSC C21189
U2: TPS61022; Texas_RWU0007A_VQFN-7_2x2mm_P0.5mm; not fitted
U3: TPS62A02DRL; SOT-563
U4: TPS563300; SOT-583-8; LCSC C5219249
U7: GigaESC TL494OC 2.1.0
U19: BOOSTER_2A_12V_MAX_FP6291LR-G1; SOT-23-6; LCSC C18701; not fitted

Connections:
4V2-FROM-12V: C25.1, C97.1, C99.1, L3.2, Q6.3 (D), R5.1, R108.2, R109.2; also elsewhere on the board
4V2-FROM-BAT: C72.1, C91.1, C92.1, Q3.1 (G), Q6.1 (G), Q8.3 (D), R11.1, R12.2, U2.3 (VOUT)
12V_BATT: D20.1 (A), D20.2 (A), FB3.2
12V_HV: D41.1 (A), D41.2 (A), F9.1
+3V3: C37.1, C38.1, L5.2, R24.1; also elsewhere on the board
+12P: D9.1 (A), D9.2 (A), R110.1, R111.1; also elsewhere on the board
+12V: C17.1, C22.1, D9.3 (K), D20.3 (K), D41.3 (K), R110.2, R111.2, U4.3 (VIN); also elsewhere on the board
+BATT: C26.1, C27.1, L4.1, U2.5 (EN), U2.7 (VIN); also elsewhere on the board
GND: C17.2, C18.2, C22.2, C25.2, C26.2, C27.2, C28.2, C29.2, C32.2, C37.2, C38.2, C72.2, C73.2, C74.2, C75.2, C82.2, C83.2, C84.2, C91.2, C92.2, C97.2, C99.2, D8.2 (A2), Q3.2 (S), R6.2, R10.2, R12.1, R23.2, R68.2, R69.2, U2.1 (GND), U2.6 (MODE), U3.1 (GND), U3.6 (PG), U4.4 (GND), U7.3 (GND), U19.2 (GND); also elsewhere on the board
HV+: F16.1; also elsewhere on the board
unnamed: D8.1 (A1), F9.2, U7.1 (+12V)
unnamed: D21.2 (A), L2.2, U19.1 (LX)
unnamed: C73.1, C74.1, C75.1, D21.1 (K), FB3.1, R113.1
unnamed: Q3.3 (D), Q8.1 (G), R13.1
unnamed: R113.2, R114.1
unnamed: R10.1, R11.2, U2.4 (FB)
unnamed: L4.2, U2.2 (SW)
unnamed: R23.1, R24.2, U3.5 (FB)
unnamed: L5.1, U3.2 (SW)
unnamed: C23.1, U4.6 (BST)
unnamed: R5.2, R6.1, U4.8 (FB)
unnamed: C23.2, L3.1, U4.5 (SW)
unnamed: F16.2, U7.2 (HV)
unnamed: R69.1, R114.2, U19.3 (FB)
unnamed: R68.1, U19.6 (OC)
VBUS: C18.1, C28.1, C29.1, C32.1, C82.1, C83.1, C84.1, L2.1, Q6.2 (S), Q8.2 (S), R13.2, R108.1, R109.1, U3.3 (VIN), U3.4 (EN), U19.4 (EN), U19.5 (Vcc); also elsewhere on the board

Notes on the sheet:
BATT BOOST TO 4V2
1A trip
IF EXT PWR EXISTS - USE THAT IF NO EXT PWR EXISTS - USE BATT
https://github.com/kaminaris/GigaESC/tree/master/PowerBoard/TL494V2OC
4V2 ORING
https://webench.ti.com/appinfo/webench/scripts/SDP.cgi?ID=62C56A5871A9F317
MAIN TO 3V3
EXT12V TO 4V2
https://webench.ti.com/appinfo/webench/scripts/SDP.cgi?ID=FB38C6AE199D341B
BATT BOOST TO 12V
ext 12V

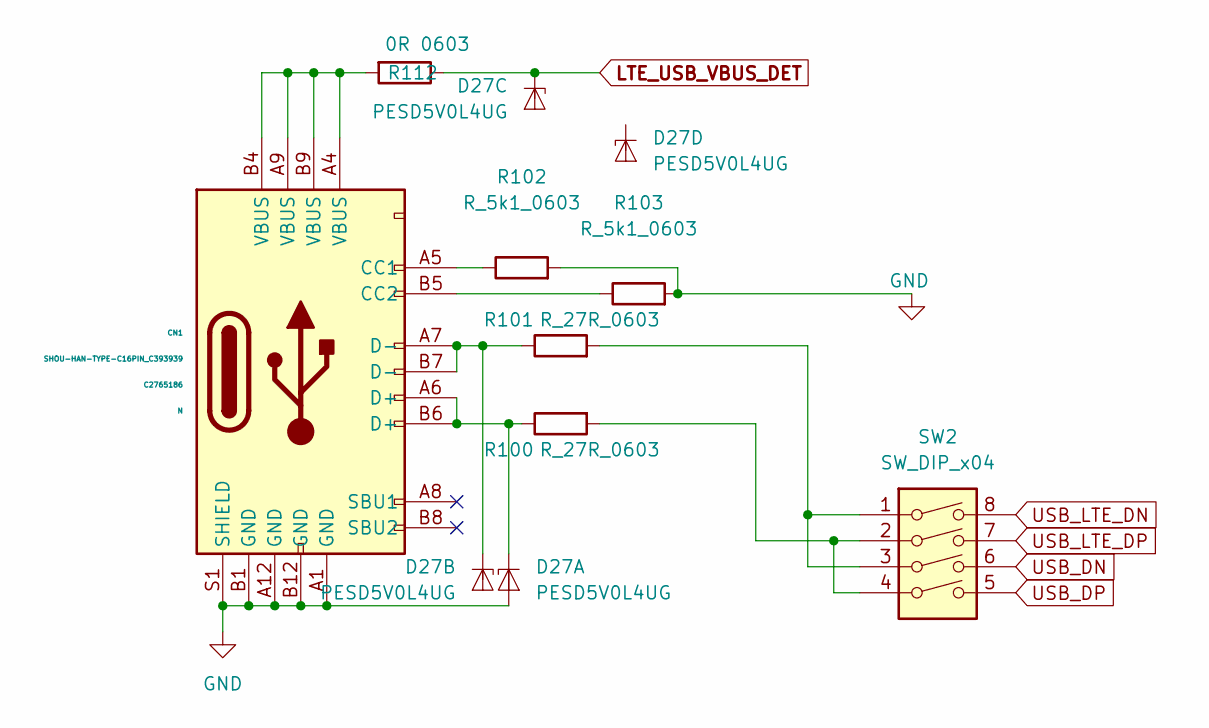
[picture p26: schematic USB.kicad_sch, VehicleMan]

Parts:
CN1: SHOU-HAN-TYPE-C16PIN_C393939; USB_C_Receptacle_HCTL_HC-TYPE-C-16P-01A; LCSC C2765186
D27: PESD5V0L4UG; SOT-353_SC-70-5; LCSC C5116450
R100, R101: R_27R_0603; R_0603_1608Metric; LCSC C101313
R102, R103: R_5k1_0603; R_0603_1608Metric; LCSC C23186
R112: 0R 0603; R_0603_1608Metric; LCSC C21189
SW2: SW_DIP_x04; SW_DIP_SPSTx04_Slide_9.78x12.34mm_W7.62mm_P2.54mm; LCSC C99418

Connections:
GND: CN1.A1 (GND), CN1.A12 (GND), CN1.B1 (GND), CN1.B12 (GND), CN1.S1 (SHIELD), D27.2 (A), R102.2, R103.2; also elsewhere on the board
LTE_USB_VBUS_DET: D27.4 (K3), R112.1; also elsewhere on the board
unnamed: CN1.A5 (CC1), R102.1
unnamed: CN1.B5 (CC2), R103.1
unnamed: CN1.A4 (VBUS), CN1.A9 (VBUS), CN1.B4 (VBUS), CN1.B9 (VBUS), R112.2
unnamed: CN1.A6 (D+), CN1.B6 (D+), D27.1 (K1), R100.1
unnamed: CN1.A7 (D-), CN1.B7 (D-), D27.3 (K2), R101.1
unnamed: R100.2, SW2.2, SW2.4
unnamed: R101.2, SW2.1, SW2.3
USB_DN: SW2.6; also elsewhere on the board
USB_DP: SW2.5; also elsewhere on the board
USB_LTE_DN: SW2.8; also elsewhere on the board
USB_LTE_DP: SW2.7; also elsewhere on the board

Board: 2 copper layers, 405 parts (0 on the bottom side), 241 nets, no tracks yet.
