skrubis/vectrix-vehicleman/(commit log)

2025-03-04 sch done-ish
    [Alarm.kicad_sch, CAN.kicad_sch, DCDC.kicad_sch, GPIO_Expander.kicad_sch, LTE.kicad_sch, USB.kicad_sch, battery-backup.kicad_sch, conn.kicad_sch]
2025-03-06 bom cleanup
    [CAN.kicad_sch, DCDC.kicad_sch, GPIO_Expander.kicad_sch, LTE.kicad_sch, battery-backup.kicad_sch, bom.csv, conn.kicad_sch, positions.csv]
